yldzmuhammed/STF7-SoM/lcdboard/7 Inch Module/doc/TFT7.JPG

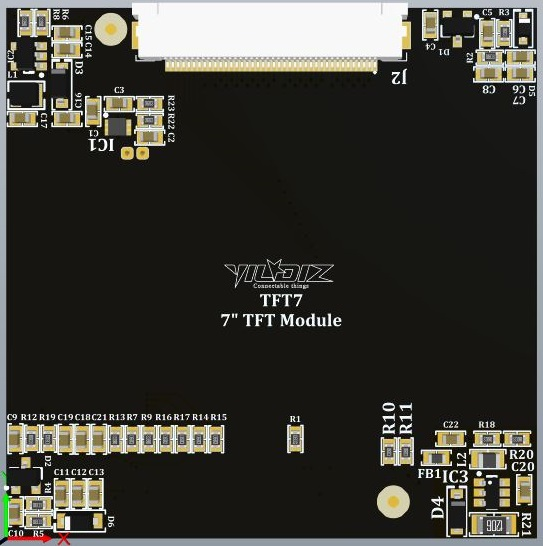
lcdboard/7 Inch Module/doc/TFT7.JPG
