yldzmuhammed/STF7-SoM/README.md

# STM32F7 Base Board

STM32F7 için hazırlanan temel kart.

Üzerinde bazı kritik çevre birimleri için bağlantı uçları yer alacak.

- SDRAM
- QSPI
- LCD with TouchPanel
- DCMI 
- UART with Rx, Tx, RTS, CTS, RING and control pins
- USB device with power
- Battery charger 1A
