yldzmuhammed/STF7-SoM/doc/Digikey Entegrelerde Çıkan Sorunlar.docx

# AP7362-33SP-13DICT-ND

Bu ürünle ilgili sorun, çıkış voltajının istenen seviyenin üzerinde olması. Bu ürün Datasheet’e göre çıkışında 3.3 volt sabit çıkış vermesi gereken bir ürün. Ancak girişinde 5 volt olduğunda, çıkışından 3,7 volt alıyoruz. Bu da devre üzerinde yer alan entegrelerimize zarar veriyor.

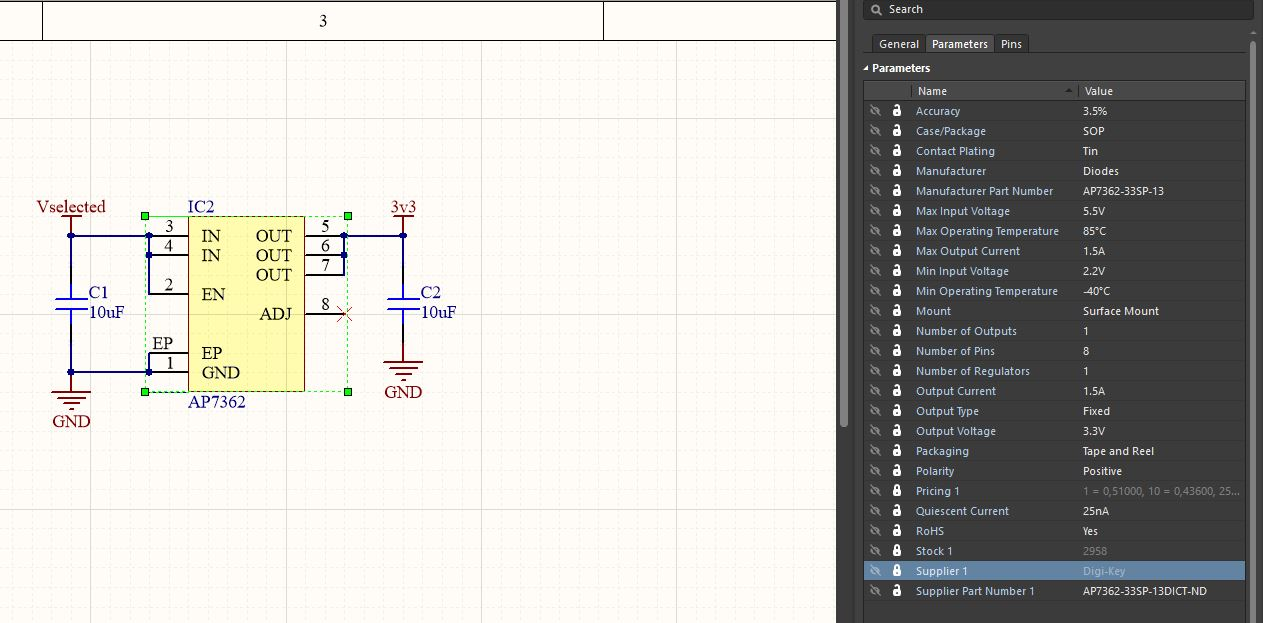
[picture p2: figure]
metin içeren bir resim Açıklama otomatik olarak oluşturuldu

# XC2884CT-ND

Bu üründen 2 adet satın alındı. Bu ürün çıkışında 24 MHz sinyal olması gerekirken, birinde hiç sinyal çıkışı alamadık, diğerinde 320 KHz sinyal çıkışı alabildik. Bu sebeple mikrodenetleyicimize çalışması için gereken saat kaynağını sağlayamadık.

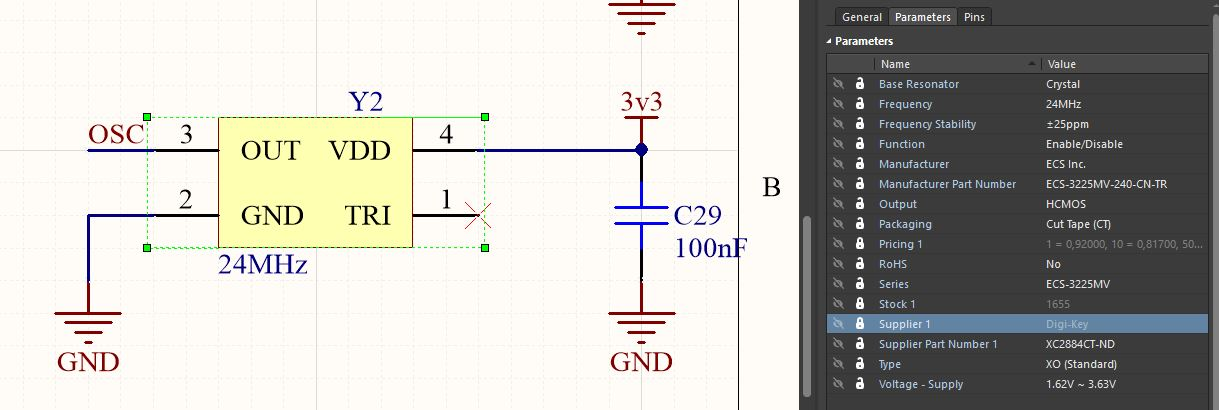
[picture p3: figure]
metin, saat içeren bir resim Açıklama otomatik olarak oluşturuldu

# 497-18106-ND

Bu ürün ST Microelectronics firmasının STM32F750N8 kodlu mikrodenetleyicisi.

- Normal şartlarda, sistemin çalışma frekansını görebilmek için PC9 ve PA8 pinlerinden saat çıkışı alabiliyor olmamız gerekirdi. Ancak bu sinyali göremiyoruz.
- Diğer başlıklarda da belirtilen hafıza entegreleriyle haberleşemiyoruz. Normal şartlarda SDRAM belleğe sorunsuz erişim sağlayabilmemiz, veri yazıp okuyabilmemiz gerekirdi. Ayrıca Paralel ve QUAD SPI NOR Flash entegrelerine de sorunsuz erişim sağlayabilmemiz, çip kimlik numaralarını okuyabilmemiz, veri yazıp okuyabilmemiz gerekirdi. Ancak bunu yapamıyoruz.
- Sorunsuz şekilde USB HS (High Speed) Device modundan PC ile iletişim kurabilmemiz, veri alışverişi yapabilmemiz gerekirdi. USB DFU, USB CDC, USB HID sınıflarından hiçbiriyle iletişim kuramıyoruz. Entegre içerisindeki USB donanımının zarar gördüğünü düşünüyoruz.
- SDIO birimini kullanarak SD Card (Hafıza kartı) ile iletişim kurabilmemiz ve karta veri yazıp okuyabilmemiz gerekirdi. Bunu yapamıyoruz.
- LTDC, DCMI gibi çevre birimlerini de kullanmamız gerekiyor. Ancak yukarıdaki sorunları çözemediğimiz için bu çevre birimlerini test edemiyoruz.
- 10KB dan daha büyük program yüklemeye kalktığımızda orijinal J-Link adaptörümüz, “Memory Miss Match” şeklinde hata veriyor. Sebebi program yükleme doğru veya hatalı şekilde gerçekleşiyor ancak yükleme sonrası çalışan doğrulama işlemi sırasında yazılmış olması gereken programın doğru şekilde yazılamadığı görülüyor. Yani program da yükleyemiyoruz.

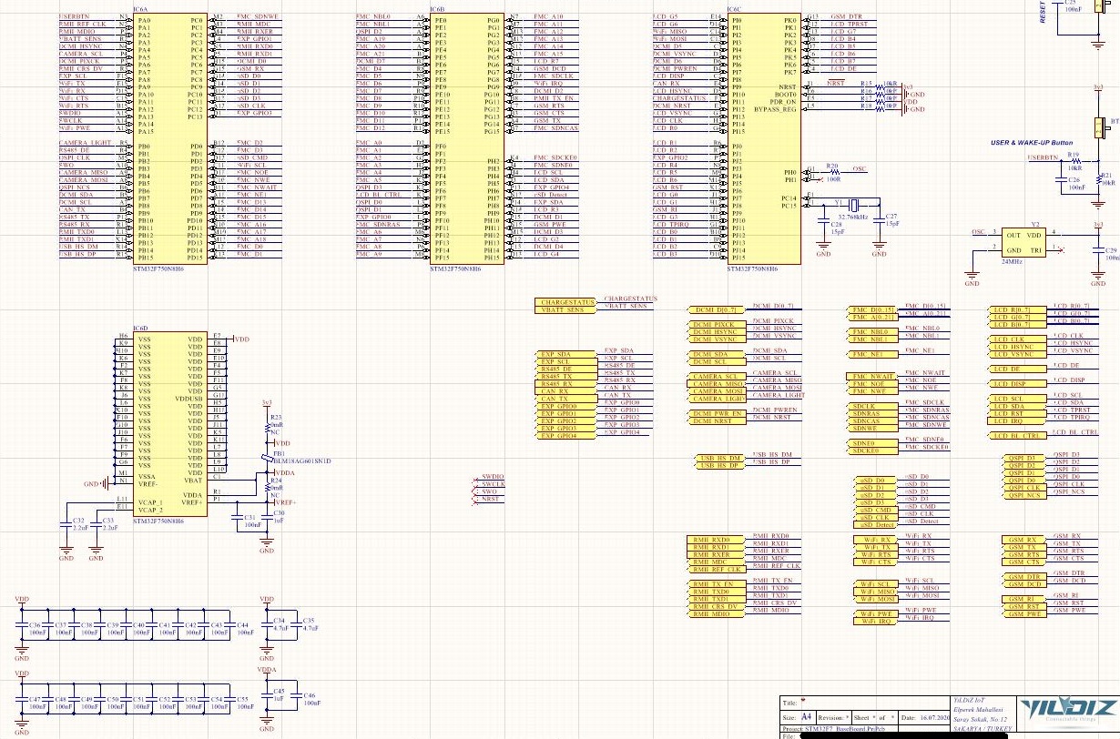
[picture p4: figure]
metin içeren bir resim Açıklama otomatik olarak oluşturuldu

# W25Q128JVPIM-ND

Bu ürün QUAD SPI NOR Flash. Normal şartlarda, mikrodenetleyici ile haberleşerek kimlik numarasını okuyabilmeli, veri yazıp okuyabilmeliydik. Ancak herhangi bir şekilde haberleşme sağlayamıyoruz. Ne kimlik numarasını okuyabiliyoruz ne de veri yazıp okuyabiliyoruz.

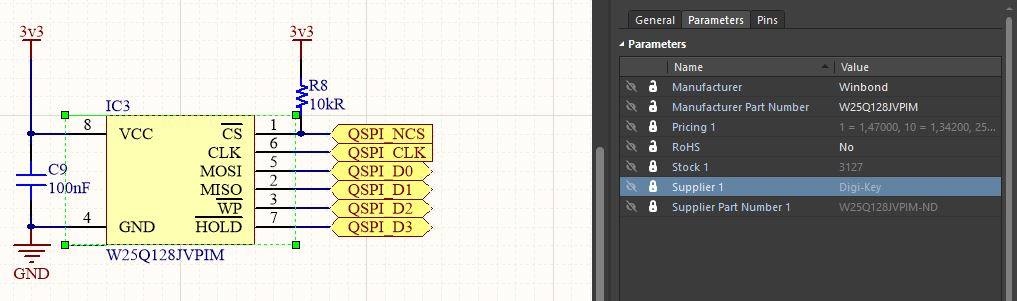
[picture p5: figure]

# 557-1777-ND

Bu ürün 22 Bit Paralel NOR Flash. Normal şartlarda, mikrodenetleyici ile haberleşerek kimlik numarasını okuyabilmeli, veri yazıp okuyabilmeliydik. Ancak herhangi bir şekilde haberleşme sağlayamıyoruz. Ne kimlik numarasını okuyabiliyoruz ne de veri yazıp okuyabiliyoruz.

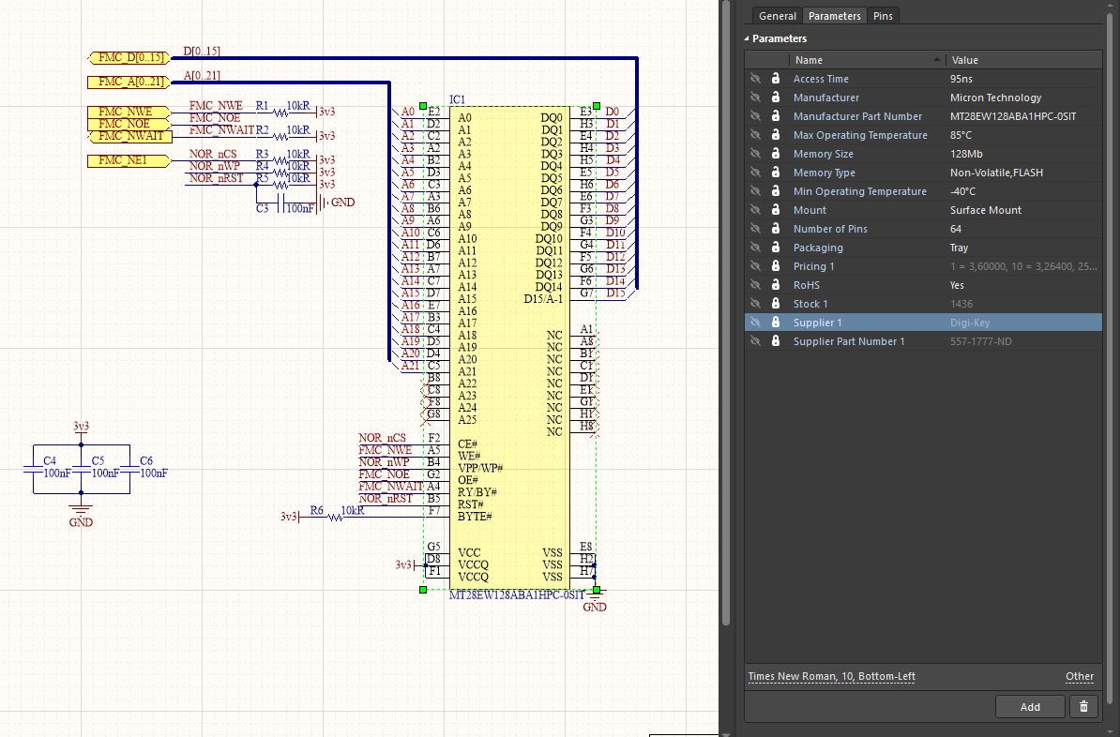
[picture p6: figure]

# 1450-1350-1-ND

Bu ürün 256 MegaBit SDRAM. Normal şartlarda, mikrodenetleyici ile haberleşerek veri yazıp okuyabilmeliydik. Ancak herhangi bir şekilde haberleşme sağlayamıyoruz. Ancak veri yazıp okuyabiliyoruz.

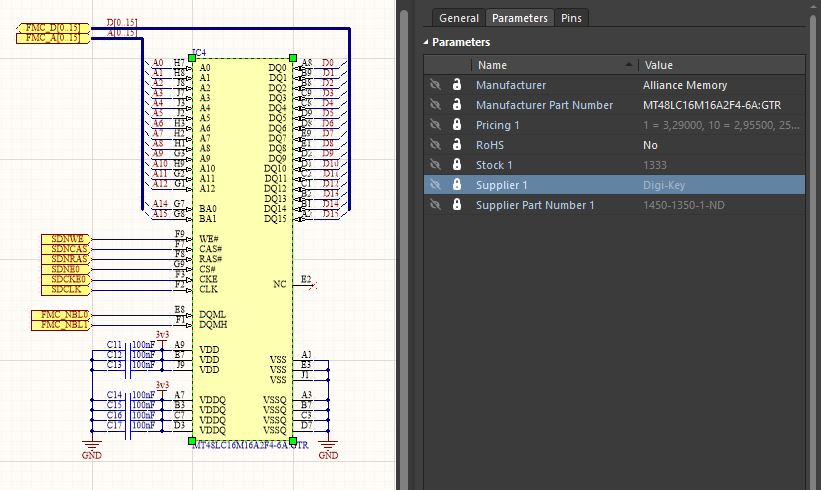
[picture p7: figure]
ekran görüntüsü içeren bir resim Açıklama otomatik olarak oluşturuldu
