yldzmuhammed/STF7-SoM/doc/System Blog Diagram.png

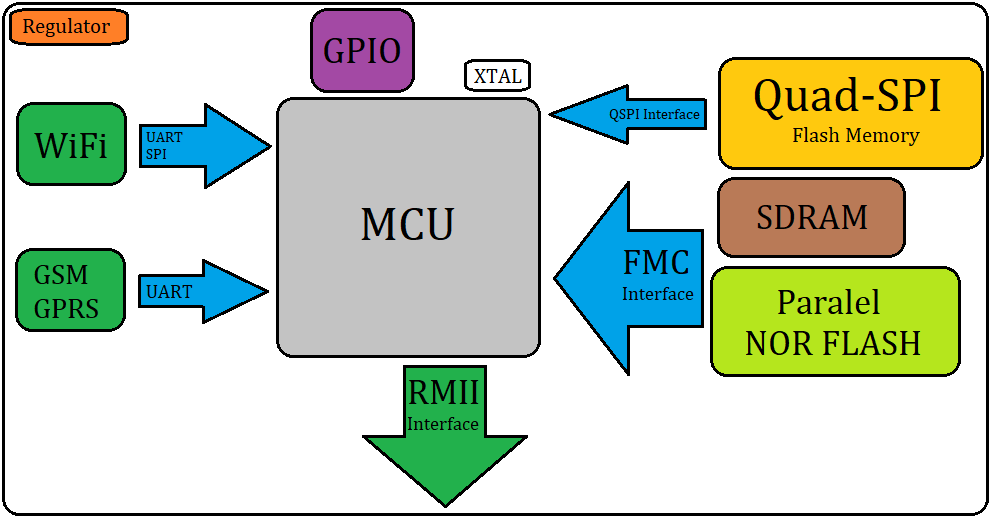
doc/System Blog Diagram.png
