yldzmuhammed/STF7-SoM/mechanical/ST7-SoM.PNG

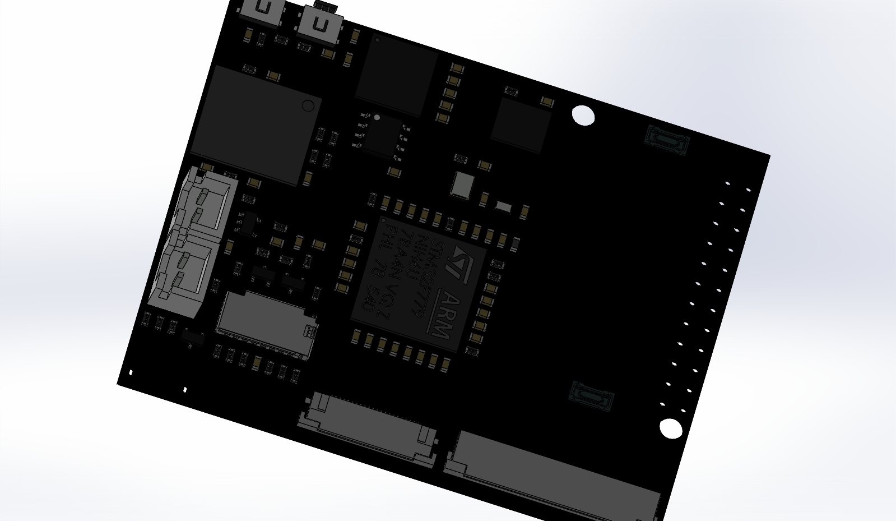
mechanical/ST7-SoM.PNG
