yldzmuhammed/STF7-SoM/lcdboard/7 Inch Module/doc/7IncModule BOM-7 Inch Module.xls

Sheet: BOM Report
Bill of Materials |  |  | 7IncModule BOM for Project [7 Inch Module.PrjPcb] (No PCB Document Selected)
Source Data From: |  | 7 Inch Module.PrjPcb
Project: |  | 7 Inch Module.PrjPcb
Variant: |  | None
Creation Date: | 19.05.2020 | 15:45
Print Date: | 2020-06-29 | 12:41:12
Production Quantity: | 1
Currency | USD
Comment | Designator | Footprint | Description | Supplier 1 | Supplier Part Number 1 | Manufacturer Part Number | Pricing 1 | Quantity | Price | Supplier Subtotal 1
1uF | C1, C2, C7, C12, C14, C17, C19 | CAP 0603/1608 | Ceramic, SMT Capacitor | Digi-Key | 1276-1182-1-ND | CL10A105KP8NNNC | 1 = 0,10000, 10 = 0,03800, 100 = 0,01680, 500 = 0,01200, 1000 = 0,00943 (USD) | 7 | 0.1 | $0.70
100nF | C3, C4, C5, C8, C9, C10, C13, C21 | CAP 0603/1608 | Capacitor, Ceramic, Ceramic, SMT Capacitor | Digi-Key | 1276-1857-1-ND | CL10A104KA8NNNC | 1 = 0,10000, 10 = 0,04600, 100 = 0,02070, 500 = 0,01478, 1000 = 0,01162 (USD), 1 = 0,10000, 10 = 0,04500, 100 = 0,02000, 500 = 0,01428, 1000 = 0,01122 (USD) | 8 | 0.1 | $0.80
10uF | C6, C11, C15, C16, C18, C20 | CAP 0603/1608 | Ceramic, SMT Capacitor | Digi-Key | 1276-1119-1-ND | CL10A106MQ8NNNC | 1 = 0,15000, 10 = 0,11000, 100 = 0,05150, 500 = 0,03614, 1000 = 0,02992 (USD) | 6 | 0.15 | $0.90
1uF | C22 | CAP 0603/1608 | Ceramic, SMT Capacitor | Digi-Key | 1276-1034-1-ND | CL10A105KO8NNNC | 1 = 0,10000, 10 = 0,03800, 100 = 0,01680, 500 = 0,01198, 1000 = 0,00941 (USD) | 1 | 0.1 | $0.10
BAT54S,235 | D1, D2 | DIODES SOT-23-3 | TVS Array | Digi-Key | 1727-1868-1-ND | BAT54S,235 | 1 = 0,14000, 10 = 0,12500, 25 = 0,11880, 100 = 0,05230, 250 = 0,05016, 500 = 0,04104, 1000 = 0,02850, 2500 = 0,02489, 5000 = 0,02233 (USD) | 2 | 0.14 | $0.28
1N5819HW-7-F | D3 | SOD-123 | Zener Diode | Digi-Key | 1N5819HW-FDICT-ND | 1N5819HW-7-F | 1 = 0,40000, 10 = 0,30100, 25 = 0,26360, 100 = 0,14310, 250 = 0,14240, 500 = 0,11678, 1000 = 0,08664 (USD) | 1 | 0.4 | $0.40
BAT54GWJ | D4 | SOD-123 | Zener Diode | Digi-Key | 1727-7328-1-ND | BAT54GWJ | 1 = 0,14000, 10 = 0,13100, 100 = 0,07140, 500 = 0,04396, 1000 = 0,02997 (USD) | 1 | 0.14 | $0.14
DDZ7V5ASF-7 | D5 | SOD323F | Zener Diode | Digi-Key | DDZ7V5ASF-7DICT-ND | DDZ7V5ASF-7 | 1 = 0,15000, 10 = 0,14100, 25 = 0,13400, 100 = 0,05890, 250 = 0,05656, 500 = 0,04626, 1000 = 0,03213 (USD) | 1 | 0.15 | $0.15
PDZ16BGWJ | D6 | SOD123F | Zener Diode | Digi-Key | 1727-7765-1-ND | PDZ16BGWJ | 1 = 0,17000, 10 = 0,15400, 25 = 0,14640, 100 = 0,06440, 250 = 0,06176, 500 = 0,05054, 1000 = 0,03510, 2500 = 0,03066, 5000 = 0,02750 (USD) | 1 | 0.17 | $0.17
BLM18PG-121SN1D | FB1 | FER 0603/1608 | SMT Ferrite Chip | Digi-Key | 490-1037-1-ND | BLM18PG-121SN1D | 1 = 0,10000, 10 = 0,07600, 25 = 0,06840, 50 = 0,05000, 100 = 0,04330, 250 = 0,03416, 500 = 0,02884, 1000 = 0,02429 (USD) | 1 | 0.1 | $0.10
MIC5353YMT-TR | IC1 | MICREL MLF-6 1.6x1.6MM | Integrated Circuit | Digi-Key | 576-3681-1-ND | MIC5353YMT-TR | 1 = 0,34000, 25 = 0,28000, 100 = 0,26000 (USD) | 1 | 0.34 | $0.34
AP3012KTR-G1 | IC2 | DIODES SOT-23-5 W5 | 1.5MHz STEP-UP DC-DC CONVERTER | Digi-Key | AP3012KTR-G1DICT-ND | AP3012KTR-G1 | 1 = 0,47000, 10 = 0,38000, 25 = 0,34760, 100 = 0,23430, 250 = 0,19392, 500 = 0,17776, 1000 = 0,13332 (USD) | 1 | 0.47 | $0.47
AP3032KTR-G1 | IC3 | DIODES SOT-23-6 W6 |  | Digi-Key | AP3032KTR-G1DICT-ND | AP3032KTR-G1 | 1 = 0,48000, 10 = 0,36500, 100 = 0,22740, 500 = 0,15558, 1000 = 0,11968 (USD) | 1 | 0.48 | $0.48
62684-501100ALF | J1 | Amphenol 62684-501100ALF | Connector | Digi-Key | 609-1197-1-ND | 62684-501100ALF | 1 = 0,96000, 10 = 0,84700, 25 = 0,79680, 50 = 0,76360, 100 = 0,73040, 250 = 0,66396, 500 = 0,59756, 1000 = 0,53117 (USD) | 1 | 0.96 | $0.96
62684-401100ALF | J2 | Amphenol 62684-401100ALF | Connector | Digi-Key | 609-1195-1-ND | 62684-401100ALF | 1 = 0,97000, 10 = 0,85600, 25 = 0,80600, 50 = 0,77240, 100 = 0,73880, 250 = 0,67168, 500 = 0,60450, 1000 = 0,53733 (USD) | 1 | 0.97 | $0.97
1734592-6 | J6 | FPC-6 |  | Digikey | A144895CT-ND | 1734592-6 | 1 = 0,44000, 10 = 0,41400, 25 = 0,37280, 50 = 0,33140, 100 = 0,31760, 250 = 0,28996, 500 = 0,27616, 1000 = 0,22783 (USD) | 1 | 0.44 | $0.44
10uH | L1 | TAIYO YUDEN MAMK2520T1R0M |  | Digi-Key | 2037-SDET25201T-100MSCT-ND | SDET25201T-100MS | 1 = 0,26000, 10 = 0,23300, 100 = 0,16050, 500 = 0,13714 1000 = 0,10505 (USD) | 1 | 0.26 | $0.26
6.8uH | L2 | FER 0805/2012 |  | Digi-Key | 445-6402-1-ND | MLZ2012M6R8WT000 | 1 = 0,14000, 10 = 0,12900, 100 = 0,08630, 500 = 0,07188, 1000 = 0,06038 (USD) | 1 | 0.14 | $0.14
1kR | R1, R8, R9, R10, R11, R13, R19 | RES 0603/1608 | Ceramic, SMT Capacitor | Digi-Key | 311-1.00KHRCT-ND | RC0603FR-071KL | 1 = 0,10000, 10 = 0,02300, 100 = 0,00940, 1000 = 0,00421, 2500 = 0,00366 (USD) | 7 | 0.1 | $0.70
15kR | R6 | RES 0603/1608 | Ceramic, SMT Capacitor | Digi-Key | 311-15.0KHRCT-ND | RC0603FR-0715KL | 1 = 0,10000, 10 = 0,02300, 100 = 0,00940, 1000 = 0,00421, 2500 = 0,00366 (USD) | 1 | 0.1 | $0.10
47kR | R18 | RES 0603/1608 | Ceramic, SMT Capacitor | Digi-Key | 311-47.0KHRCT-ND | RC0603FR-0747KL | 1 = 0,10000, 10 = 0,02400, 100 = 0,00970, 1000 = 0,00437, 2500 = 0,00379 (USD) | 1 | 0.1 | $0.10
68kR | R20 | RES 0603/1608 | Ceramic, SMT Capacitor | Digi-Key | 311-68.0KHRCT-ND | RC0603FR-0768KL | 1 = 0,10000, 10 = 0,02400, 100 = 0,00970, 1000 = 0,00437, 2500 = 0,00379 (USD) | 1 | 0.1 | $0.10
5.6R | R21 | RES 1206/3216 | Ceramic, SMT Capacitor | Digi-Key | RHM5.6ICT-ND | ESR18EZPJ5R6 | 1 = 0,16000, 10 = 0,13300, 100 = 0,05200, 1000 = 0,02178, 2500 = 0,01996 (USD) | 1 | 0.16 | $0.16
14kR | R22 | RES 0603/1608 | Ceramic, SMT Capacitor | Digi-Key | 311-14.0KHRCT-ND | RC0603FR-0714KL | 1 = 0,10000, 10 = 0,02300, 100 = 0,00940, 1000 = 0,00421, 2500 = 0,00366 (USD) | 1 | 0.1 | $0.10
10kR | R23 | RES 0603/1608 | Ceramic, SMT Capacitor | Digi-Key | RNCP0603FTD10K0CT-ND | RNCP0603FTD10K0 | 1 = 0,10000, 10 = 0,06700, 100 = 0,02730, 1000 = 0,01224, 2500 = 0,01063 (USD) | 1 | 0.1 | $0.10
 |  |  |  |  |  |  |  | 50 |  | $9.16
Approved |  | Notes

Sheet: Project Information
Project Full Path | P:\YILDIZIoT\TFT-LCD Modules\7 Inch Module\hw\7 Inch Module.PrjPcb
Project Filename | 7 Inch Module.PrjPcb
Variant Name | None
Data-Source Filename | 7 Inch Module.PrjPcb
Data-Source Full Path | P:\YILDIZIoT\TFT-LCD Modules\7 Inch Module\hw\7 Inch Module.PrjPcb
Title | 7IncModule BOM for Project [7 Inch Module.PrjPcb] (No PCB Document Selected)
Total Quantity | 50
Report Time | 15:45
Report Date | 19.05.2020
Report Date & Tine | 19.05.2020 15:45
Output Name | 7IncModule BOM
Output Type | BOM_PartType
Output Generator Name | BOM
Output Generator Description | Bill of Materials
