yldzmuhammed/STF7-SoM/baseboard/Project Outputs for STM32F7_BaseBoard/BOM/Base Board BOM-STM32F7_BaseBoard.xls

Sheet: BOM Report
Bill of Materials |  |  | Base Board BOM for Project [STM32F7_BaseBoard.PrjPcb] (No PCB Document Selected)
Source Data From: |  | STM32F7_BaseBoard.PrjPcb
Project: |  | STM32F7_BaseBoard.PrjPcb
Variant: |  | None
Creation Date: | 19.05.2020 | 15:52
Print Date: | 2020-05-19 | 15:54:15
Production Quantity: | 1
Currency | USD
Comment | Designator | Footprint | Description | Supplier 1 | Supplier Part Number 1 | Manufacturer Part Number | Pricing 1 | Quantity | #Column Name Error:' Price | Supplier Subtotal 1
USB Micro | µUSB1 | FCI USB 10118193-0001LF |  | Digi-Key | 609-4616-1-ND | 10118193-0001LF | 1 = 0,43000, 10 = 0,40500, 25 = 0,36480, 50 = 0,32420, 100 = 0,31070, 250 = 0,28368, 500 = 0,27016 (USD) | 1 | 0.43 | $0.43
#NAME? | BT1, BT2 | TactileButton | Button, 2 pin | Digi-Key | P16767CT-ND | EVQP7J01P | 1 = 0,30000, 10 = 0,28600, 25 = 0,27600, 50 = 0,26560, 100 = 0,25550, 250 = 0,23504, 500 = 0,20438, 1000 = 0,17372 (USD) | 2 | 0.3 | $0.60
10uF | C1, C2, C61, C62 | CAP 0603/1608 | Ceramic, SMT Capacitor | Digi-Key | 1276-1119-1-ND | CL10A106MQ8NNNC | 1 = 0,15000, 10 = 0,11000, 100 = 0,05150, 500 = 0,03614, 1000 = 0,02992 (USD) | 4 | 0.15 | $0.60
100nF | C3, C4, C5, C6, C9, C10, C11, C12, C13, C14, C15, C16, C17, C26, C29, C31, C36, C37, C38, C39, C40, C41, C42, C43, C44, C46, C47, C48, C49, C50, C51, C52, C53, C54, C55 | CAP 0603/1608 | Ceramic, SMT Capacitor | Digi-Key | 1276-1033-1-ND | CL10B104JB8NNNC | 1 = 0,10000, 10 = 0,04800, 100 = 0,02160, 500 = 0,01540, 1000 = 0,01210 (USD), 1 = 0,10000, 10 = 0,05300, 100 = 0,02350, 500 = 0,01680, 1000 = 0,01320 (USD) | 35 | 0.048 | $1.68
15pF | C27, C28 | CAP 0603/1608 | Ceramic, SMT Capacitor | Digi-Key | 1292-1487-1-ND | 0603N150J500CT | 1 = 0,10000, 10 = 0,03300, 100 = 0,01490, 500 = 0,01062, 1000 = 0,00835 (USD) | 2 | 0.1 | $0.20
1uF | C30, C45 | CAP 0603/1608 | Ceramic, SMT Capacitor | Digi-Key | 1276-1182-1-ND | CL10A105KP8NNNC | 1 = 0,10000, 10 = 0,03800, 100 = 0,01680, 500 = 0,01200, 1000 = 0,00943 (USD) | 2 | 0.1 | $0.20
2.2uF | C32, C33 | CAP 0603/1608 | Ceramic, SMT Capacitor | Digi-Key | 1276-1183-1-ND | CL10A225KQ8NNNC | 1 = 0,11000, 10 = 0,07700, 100 = 0,03430, 500 = 0,02450, 1000 = 0,01925 (USD) | 2 | 0.11 | $0.22
4.7uF | C34, C35, C58 | CAP 0603/1608 | Ceramic, SMT Capacitor | Digi-Key | 1276-1907-1-ND | CL10A475MQ8NNNC | 1 = 0,10000, 10 = 0,06300, 100 = 0,02790, 500 = 0,01990, 1000 = 0,01564 (USD) | 3 | 0.1 | $0.30
10nF | C56 | CAP 0603/1608 | Ceramic, SMT Capacitor | Digi-Key | 399-1092-1-ND | C0603C103J5RACTU | 1 = 0,10000, 10 = 0,05300, 100 = 0,02360, 500 = 0,01682, 1000 = 0,01322 (USD) | 1 | 0.1 | $0.10
#NAME? | FB1 | FER 0603/1608 | SMT Ferrite Chip | Digi-Key | 490-1014-1-ND | BLM18AG601SN1D | 1 = 0,10000, 10 = 0,07900, 25 = 0,07200, 50 = 0,06480, 100 = 0,04760, 250 = 0,03460, 500 = 0,03170, 1000 = 0,02738 (USD) | 1 | 0.1 | $0.10
#NAME? | IC1 | MICRON LBGA-64 11X13mm | Parallel NOR Flash Embedded Memory | Digi-Key | 557-1777-ND | MT28EW128ABA1HPC-0SIT | 1 = 3,60000, 10 = 3,26400, 25 = 3,19320, 50 = 3,17540, 100 = 2,84780, 250 = 2,83716, 500 = 2,73266, 1000 = 2,59806 (USD) | 1 | 3.6 | $3.60
AP7362 | IC2 | DIODES SO-8-EP | The AP7362 is a 1.5A adjustable output voltage linear regulator with ultra-low dropout. | Digi-Key | AP7362-33SP-13DICT-ND | AP7362-33SP-13 | 1 = 0,51000, 10 = 0,43600, 25 = 0,40640, 100 = 0,30200, 250 = 0,25552, 500 = 0,24392, 1000 = 0,18003 (USD) | 1 | 0.51 | $0.51
#NAME? | IC3 | WINBOND WSON-8 6x5mm |  | Digi-Key | W25Q128JVPIM-ND | W25Q128JVPIM | 1 = 1,47000, 10 = 1,34200, 25 = 1,30640, 50 = 1,29940, 100 = 1,16150, 250 = 1,15808, 500 = 1,14084, 1000 = 1,09189, 5000 = 1,01675 (USD) | 1 | 1.47 | $1.47
#NAME? | IC4 | MICRON VFBGA-54 8X14MM | MT48LC64M4A2 – 16 Meg x 4 x 4 banks MT48LC32M8A2 – 8 Meg x 8 x 4 banks MT48LC16M16A2 – 4 Meg x 16 x 4 banks | Digi-Key | 1450-1350-1-ND | MT48LC16M16A2F4-6A:GTR | 1 = 3,29000, 10 = 2,95500, 25 = 2,90800, 50 = 2,90020, 100 = 2,59150, 250 = 2,50728, 500 = 2,49792, 1000 = 2,32640 (USD) | 1 | 3.29 | $3.29
#NAME? | IC6 | ST TFBGA-216 13x13 0.8mm | Arm®-based Cortex®-M7 32b MCU+FPU, 462DMIPS, 64KB Flash/320+16+ 4KB RAM, USB OTG HS/FS, 25 com IF, Cam, LCD | Digi-Key | 497-18106-ND | STM32F750N8H6 | 1 = 9,70000, 10 = 8,76200, 25 = 8,35480, 100 = 7,25440, 250 = 6,92836, 500 = 6,31702, 1000 = 5,50193 (USD) | 1 | 9.7 | $9.70
#NAME? | IC7 | INFINEON SOT-23-3 | MOSFET N-CH 20V 6.3A SOT-23 | Digi-Key | IRLML6244TRPBFCT-ND | IRLML6244TRPBF | 1 = 0,36000, 10 = 0,29400, 25 = 0,26880, 100 = 0,16880, 250 = 0,16688, 500 = 0,15626, 1000 = 0,10625 (USD) | 1 | 0.36 | $0.36
#NAME? | IC9 | INFINEON SOT-23-3 | MOSFET P-CH 20V 3.7A SOT-23 | Digi-Key | IRLML6402PBFCT-ND | IRLML6402TRPBF | 1 = 0,36000, 10 = 0,28800, 25 = 0,26360, 100 = 0,16550, 250 = 0,16368, 500 = 0,15326, 1000 = 0,10421 (USD) | 1 | 0.36 | $0.36
#NAME? | IC10 | MICROCHIP SOT-23-5 OT | Miniature Single-Cell, Fully integrated Li-Ion, Li-Polymer charge management controllers | Digi-Key | MCP73831T-2ACI/OTCT-ND | MCP73831T-2ACI/OT | 1 = 0,56000, 25 = 0,47000, 100 = 0,42000 (USD) | 1 | 0.56 | $0.56
#NAME? | J1 | fpc-22 | Connector | Digi-Key | 609-4319-1-ND | SFV22R-2STE1HLF | 1 = 0,79000, 10 = 0,74300, 25 = 0,66840, 50 = 0,59420, 100 = 0,56950, 250 = 0,52000, 500 = 0,49522, 1000 = 0,40856 (USD) | 1 | 0.79 | $0.79
#NAME? | J2 | fpc-40 | Connector | Digi-Key | 609-1195-1-ND | 62684-401100ALF | 1 = 0,97000, 10 = 0,85600, 25 = 0,80600, 50 = 0,77240, 100 = 0,73880, 250 = 0,67168, 500 = 0,60450, 1000 = 0,53733 (USD) | 1 | 0.97 | $0.97
#NAME? | J3 | Molex - 0475710001 | Connector | Digi-Key | WM9731CT-ND | 0475710001 | 1 = 1,030000, 10 = 0,906000, 25 = 0,852400, 50 = 0,817000, 100 = 0,781400, 250 = 0,710400, 500 = 0,639340 (USD) | 1 | 1.03 | $1.03
#NAME? | J5, J6, J7, J8, J11 | HIROSE BM2410DS | Board to Board Connector | Digi-Key | H124928CT-ND | BM24-10DS/2-0.35V(53) | 1 = 1,05000, 10 = 0,92600, 25 = 0,87120, 50 = 0,83500, 100 = 0,79860, 250 = 0,72600, 500 = 0,65340 (USD) | 5 | 1.05 | $5.25
10kR | R1, R2, R3, R4, R5, R6, R8, R14, R15, R16, R17, R18, R19, R21, R22, R30, R31, R32, R33, R35 | RES 0603/1608 | Ceramic, SMT Capacitor | Digi-Key | RNCP0603FTD10K0CT-ND | RNCP0603FTD10K0 | 1 = 0,10000, 10 = 0,06700, 100 = 0,02730, 1000 = 0,01224, 2500 = 0,01063 (USD) | 20 | 0.067 | $1.34
4.7kR | R9, R10, R11, R12, R13 | RES 0603/1608 | Ceramic, SMT Capacitor | Digi-Key | 311-4.7KGRCT-ND | RC0603JR-074K7L | 1 = 0,10000, 10 = 0,02000, 100 = 0,00810, 1000 = 0,00362, 2500 = 0,00314 (USD) | 5 | 0.1 | $0.50
20R | R25, R26 | RES 0603/1608 | Ceramic, SMT Capacitor | Digi-Key | P20.0HCT-ND | ERJ3EKF20R0V | 1 = 0,10000, 10 = 0,06500, 100 = 0,02640, 1000 = 0,01186, 2500 = 0,01029 (USD) | 2 | 0.1 | $0.20
4.7kR | R27 | RES 0603/1608 | Ceramic, SMT Capacitor | Digi-Key | 311-4.70KHRCT-ND | RC0603FR-074K7L | 1 = 0,10000, 10 = 0,02400, 100 = 0,00970, 1000 = 0,00437, 2500 = 0,00379 (USD) | 1 | 0.1 | $0.10
30MR | R28, R29 | RES 0603/1608 | Ceramic, SMT Capacitor | Digi-Key | 541-30MAHCT-ND | CRCW060330M0JPEAHR | 1 = 0,40000, 10 = 0,28500, 100 = 0,11390, 1000 = 0,05610, 2500 = 0,05198 (USD) | 2 | 0.4 | $0.80
1kR | R34 | RES 0603/1608 | Ceramic, SMT Capacitor | Digi-Key | RHM1.0KDCT-ND | ESR03EZPJ102 | 1 = 0,10000, 10 = 0,08300, 100 = 0,03180, 1000 = 0,01398, 2500 = 0,01207 (USD) | 1 | 0.1 | $0.10
32.768kHz | Y1 | ABRACON ABS06 | CRYSTAL 32.7680KHZ 12.5PF SMD | Digi-Key | 535-10248-1-ND | ABS06-32.768KHZ-1-T | 1 = 0,80000, 10 = 0,70800, 50 = 0,66220, 100 = 0,58520, 500 = 0,55440, 1000 = 0,46200 (USD) | 1 | 0.8 | $0.80
24MHz | Y2 | Abracon ASTX-11 | OSC XO 1.544MHZ CMOS SMD | Digi-Key | XC2884CT-ND | ECS-3225MV-240-CN-TR | 1 = 0,92000, 10 = 0,81700, 50 = 0,76380, 100 = 0,67510, 500 = 0,63954 (USD) | 1 | 0.92 | $0.92
 |  |  |  |  |  |  |  | 102 |  | $37.08
Approved |  | Notes

Sheet: Project Information
Project Full Path | P:\YILDIZIoT\STM32F7-Base-Board\STM32F7_BaseBoard\STM32F7_BaseBoard.PrjPcb
Project Filename | STM32F7_BaseBoard.PrjPcb
Variant Name | None
Data-Source Filename | STM32F7_BaseBoard.PrjPcb
Data-Source Full Path | P:\YILDIZIoT\STM32F7-Base-Board\STM32F7_BaseBoard\STM32F7_BaseBoard.PrjPcb
Title | Base Board BOM for Project [STM32F7_BaseBoard.PrjPcb] (No PCB Document Selected)
Total Quantity | 102
Report Time | 15:52
Report Date | 19.05.2020
Report Date & Tine | 19.05.2020 15:52
Output Name | Base Board BOM
Output Type | BOM_PartType
Output Generator Name | BOM
Output Generator Description | Bill of Materials
