yldzmuhammed/STF7-SoM/baseboard/Project Outputs for STM32F7_BaseBoard/BOM/Camera BOM-Camera.xls

Sheet: BOM Report
Bill of Materials |  |  | Camera BOM for Schematic Document [Camera.SchDoc]
Source Data From: |  | Camera.SchDoc
Project: |  | STM32F7_BaseBoard.PrjPcb
Variant: |  | None
Creation Date: | 10.04.2020 | 14:39
Print Date: | 2020-04-10 | 14:43:00
Production Quantity: | 1
Currency | USD
Comment | Designator | Footprint | Description | Supplier 1 | Supplier Part Number 1 | Manufacturer Part Number | Pricing 1 | Quantity | #Column Name Error:' Price | Supplier Subtotal 1
SFV22R-2STE1HLF | J1 | fpc-22 | Connector | Digi-Key | 609-4319-1-ND | SFV22R-2STE1HLF | 1 = 0,79000, 10 = 0,74300, 25 = 0,66840, 50 = 0,59420, 100 = 0,56950, 250 = 0,52000, 500 = 0,49522, 1000 = 0,40856 (USD) | 1 | 0.79 | $0.79
 |  |  |  |  |  |  |  |  |  | $0.00
 |  |  |  |  |  |  |  |  |  | $0.00
 |  |  |  |  |  |  |  | 1 |  | $0.79
Approved |  | Notes

Sheet: Project Information
Project Full Path | P:\YILDIZIoT\STM32F7-Base-Board\STM32F7_BaseBoard\STM32F7_BaseBoard.PrjPcb
Project Filename | STM32F7_BaseBoard.PrjPcb
Variant Name | None
Data-Source Filename | Camera.SchDoc
Data-Source Full Path | P:\YILDIZIoT\STM32F7-Base-Board\STM32F7_BaseBoard\Camera.SchDoc
Title | Camera BOM for Schematic Document [Camera.SchDoc]
Total Quantity | 1
Report Time | 14:39
Report Date | 10.04.2020
Report Date & Tine | 10.04.2020 14:39
Output Name | Camera BOM
Output Type | BOM_PartType
Output Generator Name | BOM
Output Generator Description | Bill of Materials
