yldzmuhammed/STF7-SoM/baseboard/Project Outputs for STM32F7_BaseBoard/BOM/Connection BOM-Connections.xls

Sheet: BOM Report
Bill of Materials |  |  | Connection BOM for Schematic Document [Connections.SchDoc]
Source Data From: |  | Connections.SchDoc
Project: |  | STM32F7_BaseBoard.PrjPcb
Variant: |  | None
Creation Date: | 10.04.2020 | 14:40
Print Date: | 2020-04-10 | 14:42:15
Production Quantity: | 1
Currency | USD
Comment | Designator | Footprint | Description | Supplier 1 | Supplier Part Number 1 | Manufacturer Part Number | Pricing 1 | Quantity | #Column Name Error:' Price | Supplier Subtotal 1
BM24-10DS/2-0.35V(53) | J5, J6, J7, J8, J11, J12, J13 | HIROSE BM2410DS | Board to Board Connector | Digi-Key | H124928CT-ND | BM24-10DS/2-0.35V(53) | 1 = 1,05000, 10 = 0,92600, 25 = 0,87120, 50 = 0,83500, 100 = 0,79860, 250 = 0,72600, 500 = 0,65340 (USD) | 7 | 1.05 | $7.35
 |  |  |  |  |  |  |  |  |  | $0.00
 |  |  |  |  |  |  |  |  |  | $0.00
 |  |  |  |  |  |  |  | 7 |  | $7.35
Approved |  | Notes

Sheet: Project Information
Project Full Path | P:\YILDIZIoT\STM32F7-Base-Board\STM32F7_BaseBoard\STM32F7_BaseBoard.PrjPcb
Project Filename | STM32F7_BaseBoard.PrjPcb
Variant Name | None
Data-Source Filename | Connections.SchDoc
Data-Source Full Path | P:\YILDIZIoT\STM32F7-Base-Board\STM32F7_BaseBoard\Connections.SchDoc
Title | Connection BOM for Schematic Document [Connections.SchDoc]
Total Quantity | 7
Report Time | 14:40
Report Date | 10.04.2020
Report Date & Tine | 10.04.2020 14:40
Output Name | Connection BOM
Output Type | BOM_PartType
Output Generator Name | BOM
Output Generator Description | Bill of Materials
