yldzmuhammed/STF7-SoM/baseboard/Project Outputs for STM32F7_BaseBoard/BOM/LCD BOM-LCD.xls

Sheet: BOM Report
Bill of Materials |  |  | LCD BOM for Schematic Document [LCD.SchDoc]
Source Data From: |  | LCD.SchDoc
Project: |  | STM32F7_BaseBoard.PrjPcb
Variant: |  | None
Creation Date: | 10.04.2020 | 14:39
Print Date: | 2020-04-10 | 14:43:03
Production Quantity: | 1
Currency | USD
Comment | Designator | Footprint | Description | Supplier 1 | Supplier Part Number 1 | Manufacturer Part Number | Pricing 1 | Quantity | #Column Name Error:' Price | Supplier Subtotal 1
62684-401100ALF | J2 | fpc-40 | Connector | Digi-Key | 609-1195-1-ND | 62684-401100ALF | 1 = 0,97000, 10 = 0,85600, 25 = 0,80600, 50 = 0,77240, 100 = 0,73880, 250 = 0,67168, 500 = 0,60450, 1000 = 0,53733 (USD) | 1 | 0.97 | $0.97
 |  |  |  |  |  |  |  |  |  | $0.00
 |  |  |  |  |  |  |  |  |  | $0.00
 |  |  |  |  |  |  |  | 1 |  | $0.97
Approved |  | Notes

Sheet: Project Information
Project Full Path | P:\YILDIZIoT\STM32F7-Base-Board\STM32F7_BaseBoard\STM32F7_BaseBoard.PrjPcb
Project Filename | STM32F7_BaseBoard.PrjPcb
Variant Name | None
Data-Source Filename | LCD.SchDoc
Data-Source Full Path | P:\YILDIZIoT\STM32F7-Base-Board\STM32F7_BaseBoard\LCD.SchDoc
Title | LCD BOM for Schematic Document [LCD.SchDoc]
Total Quantity | 1
Report Time | 14:39
Report Date | 10.04.2020
Report Date & Tine | 10.04.2020 14:39
Output Name | LCD BOM
Output Type | BOM_PartType
Output Generator Name | BOM
Output Generator Description | Bill of Materials
