yldzmuhammed/STF7-SoM/baseboard/Project Outputs for STM32F7_BaseBoard/BOM/NOR BOM-Paralel NOR FLASH.xls

Sheet: BOM Report
Bill of Materials |  |  | NOR BOM for Schematic Document [Paralel NOR FLASH.SchDoc]
Source Data From: |  | Paralel NOR FLASH.SchDoc
Project: |  | STM32F7_BaseBoard.PrjPcb
Variant: |  | None
Creation Date: | 10.04.2020 | 14:38
Print Date: | 2020-04-10 | 14:43:12
Production Quantity: | 1
Currency | USD
Comment | Designator | Footprint | Description | Supplier 1 | Supplier Part Number 1 | Manufacturer Part Number | Pricing 1 | Quantity | #Column Name Error:' Price | Supplier Subtotal 1
100nF | C3, C4, C5, C6 | CAP 0603/1608 | Ceramic, SMT Capacitor | Digi-Key | 1276-1033-1-ND | CL10B104JB8NNNC | 1 = 0,10000, 10 = 0,04800, 100 = 0,02160, 500 = 0,01540, 1000 = 0,01210 (USD) | 4 | 0.1 | $0.40
MT28EW128ABA1HPC-0SIT | IC1 | MICRON LBGA-64 11X13mm | Parallel NOR Flash Embedded Memory | Digi-Key | 557-1777-ND | MT28EW128ABA1HPC-0SIT | 1 = 3,60000, 10 = 3,26400, 25 = 3,19320, 50 = 3,17540, 100 = 2,84780, 250 = 2,83716, 500 = 2,73266, 1000 = 2,59806 (USD) | 1 | 3.6 | $3.60
10kR | R1, R2, R3, R4, R5, R6 | RES 0603/1608 | Ceramic, SMT Capacitor | Digi-Key | RNCP0603FTD10K0CT-ND | RNCP0603FTD10K0 | 1 = 0,10000, 10 = 0,06700, 100 = 0,02730, 1000 = 0,01224, 2500 = 0,01063 (USD) | 6 | 0.1 | $0.60
 |  |  |  |  |  |  |  | 11 |  | $4.60
Approved |  | Notes

Sheet: Project Information
Project Full Path | P:\YILDIZIoT\STM32F7-Base-Board\STM32F7_BaseBoard\STM32F7_BaseBoard.PrjPcb
Project Filename | STM32F7_BaseBoard.PrjPcb
Variant Name | None
Data-Source Filename | Paralel NOR FLASH.SchDoc
Data-Source Full Path | P:\YILDIZIoT\STM32F7-Base-Board\STM32F7_BaseBoard\Paralel NOR FLASH.SchDoc
Title | NOR BOM for Schematic Document [Paralel NOR FLASH.SchDoc]
Total Quantity | 11
Report Time | 14:38
Report Date | 10.04.2020
Report Date & Tine | 10.04.2020 14:38
Output Name | NOR BOM
Output Type | BOM_PartType
Output Generator Name | BOM
Output Generator Description | Bill of Materials
