yldzmuhammed/STF7-SoM/baseboard/Project Outputs for STM32F7_BaseBoard/BOM/Power BOM-Power.xls

Sheet: BOM Report
Bill of Materials |  |  | Power BOM for Schematic Document [Power.SchDoc]
Source Data From: |  | Power.SchDoc
Project: |  | STM32F7_BaseBoard.PrjPcb
Variant: |  | None
Creation Date: | 10.04.2020 | 14:38
Print Date: | 2020-04-10 | 14:44:14
Production Quantity: | 1
Currency | USD
Comment | Designator | Footprint | Description | Supplier 1 | Supplier Part Number 1 | Manufacturer Part Number | Pricing 1 | Quantity | #Column Name Error:' Price | Supplier Subtotal 1
1uF | C1, C7 | CAP 0603/1608 | Ceramic, SMT Capacitor | Digi-Key | 1276-1182-1-ND | CL10A105KP8NNNC | 1 = 0,10000, 10 = 0,03800, 100 = 0,01680, 500 = 0,01200, 1000 = 0,00943 (USD) | 2 | 0.1 | $0.20
100nF | C2 | CAP 0603/1608 | Ceramic, SMT Capacitor | Digi-Key | 1276-1033-1-ND | CL10B104JB8NNNC | 1 = 0,10000, 10 = 0,05300, 100 = 0,02350, 500 = 0,01680, 1000 = 0,01320 (USD) | 1 | 0.1 | $0.10
10nF | C56 | CAP 0603/1608 | Ceramic, SMT Capacitor | Digi-Key | 399-1092-1-ND | C0603C103J5RACTU | 1 = 0,10000, 10 = 0,05300, 100 = 0,02360, 500 = 0,01682, 1000 = 0,01322 (USD) | 1 | 0.1 | $0.10
4.7uF | C58 | CAP 0603/1608 | Ceramic, SMT Capacitor | Digi-Key | 1276-1907-1-ND | CL10A475MQ8NNNC | 1 = 0,10000, 10 = 0,06300, 100 = 0,02790, 500 = 0,01990, 1000 = 0,01564 (USD) | 1 | 0.1 | $0.10
10uF | C61, C62 | CAP 0603/1608 | Ceramic, SMT Capacitor | Digi-Key | 1276-1119-1-ND | CL10A106MQ8NNNC | 1 = 0,15000, 10 = 0,11000, 100 = 0,05150, 500 = 0,03614, 1000 = 0,02992 (USD) | 2 | 0.15 | $0.30
MIC5353YMT-TR | IC2 | MICREL MLF-6 1.6x1.6MM | Integrated Circuit | Digi-Key | 576-3681-1-ND | MIC5353YMT-TR | 1 = 0,34000, 25 = 0,28000, 100 = 0,26000 (USD) | 1 | 0.34 | $0.34
IRLML6244TRPBF | IC7 | INFINEON SOT-23-3 | MOSFET N-CH 20V 6.3A SOT-23 | Digi-Key | IRLML6244TRPBFCT-ND | IRLML6244TRPBF | 1 = 0,36000, 10 = 0,29400, 25 = 0,26880, 100 = 0,16880, 250 = 0,16688, 500 = 0,15626, 1000 = 0,10625 (USD) | 1 | 0.36 | $0.36
IRLML6402TRPBF | IC9 | INFINEON SOT-23-3 | MOSFET P-CH 20V 3.7A SOT-23 | Digi-Key | IRLML6402PBFCT-ND | IRLML6402TRPBF | 1 = 0,36000, 10 = 0,28800, 25 = 0,26360, 100 = 0,16550, 250 = 0,16368, 500 = 0,15326, 1000 = 0,10421 (USD) | 1 | 0.36 | $0.36
MCP73831T-2ACI/OT | IC10 | MICROCHIP SOT-23-5 OT | Miniature Single-Cell, Fully integrated Li-Ion, Li-Polymer charge management controllers | Digi-Key | MCP73831T-2ACI/OTCT-ND | MCP73831T-2ACI/OT | 1 = 0,56000, 25 = 0,47000, 100 = 0,42000 (USD) | 1 | 0.56 | $0.56
14kR | R7 | RES 0603/1608 | Ceramic, SMT Capacitor | Digi-Key | 311-14.0KHRCT-ND | RC0603FR-0714KL | 1 = 0,10000, 10 = 0,02300, 100 = 0,00940, 1000 = 0,00421, 2500 = 0,00366 (USD) | 1 | 0.1 | $0.10
30MR | R28, R29 | RES 0603/1608 | Ceramic, SMT Capacitor | Digi-Key | 541-30MAHCT-ND | CRCW060330M0JPEAHR | 1 = 0,40000, 10 = 0,28500, 100 = 0,11390, 1000 = 0,05610, 2500 = 0,05198 (USD) | 2 | 0.4 | $0.80
10kR | R30, R31, R32, R33, R35, R36 | RES 0603/1608 | Ceramic, SMT Capacitor | Digi-Key | RNCP0603FTD10K0CT-ND | RNCP0603FTD10K0 | 1 = 0,10000, 10 = 0,06700, 100 = 0,02730, 1000 = 0,01224, 2500 = 0,01063 (USD) | 6 | 0.1 | $0.60
1kR | R34 | RES 0603/1608 | Ceramic, SMT Capacitor | Digi-Key | RHM1.0KDCT-ND | ESR03EZPJ102 | 1 = 0,10000, 10 = 0,08300, 100 = 0,03180, 1000 = 0,01398, 2500 = 0,01207 (USD) | 1 | 0.1 | $0.10
 |  |  |  |  |  |  |  | 21 |  | $4.02
Approved |  | Notes

Sheet: Project Information
Project Full Path | P:\YILDIZIoT\STM32F7-Base-Board\STM32F7_BaseBoard\STM32F7_BaseBoard.PrjPcb
Project Filename | STM32F7_BaseBoard.PrjPcb
Variant Name | None
Data-Source Filename | Power.SchDoc
Data-Source Full Path | P:\YILDIZIoT\STM32F7-Base-Board\STM32F7_BaseBoard\Power.SchDoc
Title | Power BOM for Schematic Document [Power.SchDoc]
Total Quantity | 21
Report Time | 14:38
Report Date | 10.04.2020
Report Date & Tine | 10.04.2020 14:38
Output Name | Power BOM
Output Type | BOM_PartType
Output Generator Name | BOM
Output Generator Description | Bill of Materials
