yldzmuhammed/STF7-SoM/baseboard/Project Outputs for STM32F7_BaseBoard/BOM/QSPI BOM-QSPI FLASH.xls

Sheet: BOM Report
Bill of Materials |  |  | QSPI BOM for Schematic Document [QSPI FLASH.SchDoc]
Source Data From: |  | QSPI FLASH.SchDoc
Project: |  | STM32F7_BaseBoard.PrjPcb
Variant: |  | None
Creation Date: | 10.04.2020 | 14:38
Print Date: | 2020-04-10 | 14:43:20
Production Quantity: | 1
Currency | USD
Comment | Designator | Footprint | Description | Supplier 1 | Supplier Part Number 1 | Manufacturer Part Number | Pricing 1 | Quantity | #Column Name Error:' Price | Supplier Subtotal 1
100nF | C9 | CAP 0603/1608 | Ceramic, SMT Capacitor | Digi-Key | 1276-1033-1-ND | CL10B104JB8NNNC | 1 = 0,10000, 10 = 0,04800, 100 = 0,02160, 500 = 0,01540, 1000 = 0,01210 (USD) | 1 | 0.1 | $0.10
W25Q128JVPIM | IC3 | WINBOND WSON-8 6x5mm |  | Digi-Key | W25Q128JVPIM-ND | W25Q128JVPIM | 1 = 1,47000, 10 = 1,34200, 25 = 1,30640, 50 = 1,29940, 100 = 1,16150, 250 = 1,15808, 500 = 1,14084, 1000 = 1,09189, 5000 = 1,01675 (USD) | 1 | 1.47 | $1.47
10kR | R8 | RES 0603/1608 | Ceramic, SMT Capacitor | Digi-Key | RNCP0603FTD10K0CT-ND | RNCP0603FTD10K0 | 1 = 0,10000, 10 = 0,06700, 100 = 0,02730, 1000 = 0,01224, 2500 = 0,01063 (USD) | 1 | 0.1 | $0.10
 |  |  |  |  |  |  |  | 3 |  | $1.67
Approved |  | Notes

Sheet: Project Information
Project Full Path | P:\YILDIZIoT\STM32F7-Base-Board\STM32F7_BaseBoard\STM32F7_BaseBoard.PrjPcb
Project Filename | STM32F7_BaseBoard.PrjPcb
Variant Name | None
Data-Source Filename | QSPI FLASH.SchDoc
Data-Source Full Path | P:\YILDIZIoT\STM32F7-Base-Board\STM32F7_BaseBoard\QSPI FLASH.SchDoc
Title | QSPI BOM for Schematic Document [QSPI FLASH.SchDoc]
Total Quantity | 3
Report Time | 14:38
Report Date | 10.04.2020
Report Date & Tine | 10.04.2020 14:38
Output Name | QSPI BOM
Output Type | BOM_PartType
Output Generator Name | BOM
Output Generator Description | Bill of Materials
