yldzmuhammed/STF7-SoM/baseboard/Project Outputs for STM32F7_BaseBoard/BOM/SD Card BOM-SD Card.xls

Sheet: BOM Report
Bill of Materials |  |  | SD Card BOM for Schematic Document [SD Card.SchDoc]
Source Data From: |  | SD Card.SchDoc
Project: |  | STM32F7_BaseBoard.PrjPcb
Variant: |  | None
Creation Date: | 10.04.2020 | 14:39
Print Date: | 2020-04-10 | 14:42:56
Production Quantity: | 1
Currency | USD
Comment | Designator | Footprint | Description | Supplier 1 | Supplier Part Number 1 | Manufacturer Part Number | Pricing 1 | Quantity | #Column Name Error:' Price | Supplier Subtotal 1
100nF | C10 | CAP 0603/1608 | Ceramic, SMT Capacitor | Digi-Key | 1276-1033-1-ND | CL10B104JB8NNNC | 1 = 0,10000, 10 = 0,05300, 100 = 0,02350, 500 = 0,01680, 1000 = 0,01320 (USD) | 1 | 0.1 | $0.10
0475710001 | J3 | Molex - 0475710001 | Connector | Digi-Key | WM9731CT-ND | 0475710001 | 1 = 1,030000, 10 = 0,906000, 25 = 0,852400, 50 = 0,817000, 100 = 0,781400, 250 = 0,710400, 500 = 0,639340 (USD) | 1 | 1.03 | $1.03
4.7kR | R9, R10, R11, R12, R13 | RES 0603/1608 | Ceramic, SMT Capacitor | Digi-Key | 311-4.7KGRCT-ND | RC0603JR-074K7L | 1 = 0,10000, 10 = 0,02000, 100 = 0,00810, 1000 = 0,00362, 2500 = 0,00314 (USD) | 5 | 0.1 | $0.50
10kR | R14 | RES 0603/1608 | Ceramic, SMT Capacitor | Digi-Key | RNCP0603FTD10K0CT-ND | RNCP0603FTD10K0 | 1 = 0,10000, 10 = 0,06700, 100 = 0,02730, 1000 = 0,01224, 2500 = 0,01063 (USD) | 1 | 0.1 | $0.10
 |  |  |  |  |  |  |  | 8 |  | $1.73
Approved |  | Notes

Sheet: Project Information
Project Full Path | P:\YILDIZIoT\STM32F7-Base-Board\STM32F7_BaseBoard\STM32F7_BaseBoard.PrjPcb
Project Filename | STM32F7_BaseBoard.PrjPcb
Variant Name | None
Data-Source Filename | SD Card.SchDoc
Data-Source Full Path | P:\YILDIZIoT\STM32F7-Base-Board\STM32F7_BaseBoard\SD Card.SchDoc
Title | SD Card BOM for Schematic Document [SD Card.SchDoc]
Total Quantity | 8
Report Time | 14:39
Report Date | 10.04.2020
Report Date & Tine | 10.04.2020 14:39
Output Name | SD Card BOM
Output Type | BOM_PartType
Output Generator Name | BOM
Output Generator Description | Bill of Materials
