yldzmuhammed/STF7-SoM/baseboard/Project Outputs for STM32F7_BaseBoard/BOM/SDRAM BOM-SDRAM 1.xls

Sheet: BOM Report
Bill of Materials |  |  | SDRAM BOM for Schematic Document [SDRAM 1.SchDoc]
Source Data From: |  | SDRAM 1.SchDoc
Project: |  | STM32F7_BaseBoard.PrjPcb
Variant: |  | None
Creation Date: | 10.04.2020 | 14:39
Print Date: | 2020-04-10 | 14:39:10
Production Quantity: | 1
Currency | USD
Comment | Designator | Footprint | Description | Supplier 1 | Supplier Part Number 1 | Manufacturer Part Number | Pricing 1 | Quantity | #Column Name Error:' Price | Supplier Subtotal 1
100nF | C11, C12, C13, C14, C15, C16, C17 | CAP 0603/1608 | Ceramic, SMT Capacitor | Digi-Key | 1276-1033-1-ND | CL10B104JB8NNNC | 1 = 0,10000, 10 = 0,04800, 100 = 0,02160, 500 = 0,01540, 1000 = 0,01210 (USD) | 7 |  | $0.00
MT48LC16M16A2F4-6A:GTR | IC4 | MICRON VFBGA-54 8X14MM | MT48LC64M4A2 – 16 Meg x 4 x 4 banks MT48LC32M8A2 – 8 Meg x 8 x 4 banks MT48LC16M16A2 – 4 Meg x 16 x 4 banks | Digi-Key | 1450-1350-1-ND | MT48LC16M16A2F4-6A:GTR | 1 = 3,29000, 10 = 2,95500, 25 = 2,90800, 50 = 2,90020, 100 = 2,59150, 250 = 2,50728, 500 = 2,49792, 1000 = 2,32640 (USD) | 1 |  | $0.00
 |  |  |  |  |  |  |  |  |  | $0.00
 |  |  |  |  |  |  |  | 8 |  | $0.00
Approved |  | Notes

Sheet: Project Information
Project Full Path | P:\YILDIZIoT\STM32F7-Base-Board\STM32F7_BaseBoard\STM32F7_BaseBoard.PrjPcb
Project Filename | STM32F7_BaseBoard.PrjPcb
Variant Name | None
Data-Source Filename | SDRAM 1.SchDoc
Data-Source Full Path | P:\YILDIZIoT\STM32F7-Base-Board\STM32F7_BaseBoard\SDRAM 1.SchDoc
Title | SDRAM BOM for Schematic Document [SDRAM 1.SchDoc]
Total Quantity | 8
Report Time | 14:39
Report Date | 10.04.2020
Report Date & Tine | 10.04.2020 14:39
Output Name | SDRAM BOM
Output Type | BOM_PartType
Output Generator Name | BOM
Output Generator Description | Bill of Materials
