yldzmuhammed/STF7-SoM/baseboard/Project Outputs for STM32F7_BaseBoard/BOM/USB BOM-USB.xls

Sheet: BOM Report
Bill of Materials |  |  | USB BOM for Schematic Document [USB.SchDoc]
Source Data From: |  | USB.SchDoc
Project: |  | STM32F7_BaseBoard.PrjPcb
Variant: |  | None
Creation Date: | 10.04.2020 | 14:39
Print Date: | 2020-04-10 | 14:42:21
Production Quantity: | 1
Currency | USD
Comment | Designator | Footprint | Description | Supplier 1 | Supplier Part Number 1 | Manufacturer Part Number | Pricing 1 | Quantity | #Column Name Error:' Price | Supplier Subtotal 1
USB Micro | µUSB1 | FCI USB 10118193-0001LF |  | Digi-Key | 609-4616-1-ND | 10118193-0001LF | 1 = 0,43000, 10 = 0,40500, 25 = 0,36480, 50 = 0,32420, 100 = 0,31070, 250 = 0,28368, 500 = 0,27016 (USD) | 1 | 0.3 | $0.30
20R | R25, R26 | RES 0603/1608 | Ceramic, SMT Capacitor | Digi-Key | P20.0HCT-ND | ERJ3EKF20R0V | 1 = 0,10000, 10 = 0,06500, 100 = 0,02640, 1000 = 0,01186, 2500 = 0,01029 (USD) | 2 | 0.1 | $0.20
4.7kR | R27 | RES 0603/1608 | Ceramic, SMT Capacitor | Digi-Key | 311-4.70KHRCT-ND | RC0603FR-074K7L | 1 = 0,10000, 10 = 0,02400, 100 = 0,00970, 1000 = 0,00437, 2500 = 0,00379 (USD) | 1 | 0.1 | $0.10
 |  |  |  |  |  |  |  | 4 |  | $0.60
Approved |  | Notes

Sheet: Project Information
Project Full Path | P:\YILDIZIoT\STM32F7-Base-Board\STM32F7_BaseBoard\STM32F7_BaseBoard.PrjPcb
Project Filename | STM32F7_BaseBoard.PrjPcb
Variant Name | None
Data-Source Filename | USB.SchDoc
Data-Source Full Path | P:\YILDIZIoT\STM32F7-Base-Board\STM32F7_BaseBoard\USB.SchDoc
Title | USB BOM for Schematic Document [USB.SchDoc]
Total Quantity | 4
Report Time | 14:39
Report Date | 10.04.2020
Report Date & Tine | 10.04.2020 14:39
Output Name | USB BOM
Output Type | BOM_PartType
Output Generator Name | BOM
Output Generator Description | Bill of Materials
