yldzmuhammed/STF7-SoM/expansionboard/hw/Project Outputs for STM32F7_ExpansionBoard/BOM/CAN BOM-CAN.xls

Sheet: BOM Report
Bill of Materials |  |  | CAN BOM for Schematic Document [CAN.SchDoc]
Source Data From: |  | CAN.SchDoc
Project: |  | STM32F7_ExpansionBoard.PrjPcb
Variant: |  | None
Creation Date: | 10.04.2020 | 14:48
Print Date: | 2020-04-10 | 14:50:14
Production Quantity: | 1
Currency | USD
Comment | Designator | Footprint | Description | Supplier 1 | Supplier Part Number 1 | Manufacturer Part Number | Pricing 1 | Quantity | #Column Name Error:' Price | Supplier Subtotal 1
47uF | C1, C3 | CAP 0603/1608 | Ceramic, SMT Capacitor | Digi-Key | 490-13244-1-ND | GRM188C80E476ME05D | 1 = 0,55000, 10 = 0,38500, 100 = 0,25380, 500 = 0,18800, 1000 = 0,15979 (USD) | 2 | 0.55 | $1.10
100nF | C2, C4 | CAP 0603/1608 | Ceramic, SMT Capacitor | Digi-Key | 399-1100-1-ND | C0603C104Z3VACTU | 1 = 0,10000, 10 = 0,03200, 100 = 0,01430, 500 = 0,01020, 1000 = 0,00802 (USD) | 2 | 0.1 | $0.20
AQ24CANFD-02HTG | D1 | ON SEMI SOT-23-3 | TVS DIODE 24V 44V SOT23-3 | Digi-Key | F10993CT-ND | AQ24CANFD-02HTG | 1 = 0,41000, 10 = 0,32900, 25 = 0,30120, 100 = 0,18900, 250 = 0,18692, 500 = 0,17500, 1000 = 0,11900 (USD) | 1 | 0.41 | $0.41
TJA1042T/3/1J | IC1 | NXP SOIC-8 | High Speed CAN, CAN FD Transceiver | Digi-Key | 568-12625-1-ND | TJA1042T/3/1J | 1 = 1,24000, 10 = 1,11300, 25 = 1,05600, 100 = 0,81100, 250 = 0,71668, 500 = 0,67896, 1000 = 0,52808 (USD) | 1 | 1.24 | $1.24
120R | R1 | RES 0603/1608 | Ceramic, SMT Capacitor | Digi-Key | RR08P120DCT-ND | RR0816P-121-D | 1 = 0,11000, 10 = 0,09800, 100 = 0,03760, 1000 = 0,01654, 2500 = 0,01428 (USD) | 1 | 0.11 | $0.11
10kR | R3 | RES 0603/1608 | Ceramic, SMT Capacitor | Digi-Key | RNCP0603FTD10K0CT-ND | RNCP0603FTD10K0 | 1 = 0,10000, 10 = 0,06700, 100 = 0,02730, 1000 = 0,01224, 2500 = 0,01063 (USD) | 1 | 0.1 | $0.10
 |  |  |  |  |  |  |  | 8 |  | $3.16
Approved |  | Notes

Sheet: Project Information
Project Full Path | P:\YILDIZIoT\STM32F7-ExpansionBoard\STM32F7_ExpansionBoard\STM32F7_ExpansionBoard.PrjPcb
Project Filename | STM32F7_ExpansionBoard.PrjPcb
Variant Name | None
Data-Source Filename | CAN.SchDoc
Data-Source Full Path | P:\YILDIZIoT\STM32F7-ExpansionBoard\STM32F7_ExpansionBoard\CAN.SchDoc
Title | CAN BOM for Schematic Document [CAN.SchDoc]
Total Quantity | 8
Report Time | 14:48
Report Date | 10.04.2020
Report Date & Tine | 10.04.2020 14:48
Output Name | CAN BOM
Output Type | BOM_PartType
Output Generator Name | BOM
Output Generator Description | Bill of Materials
