yldzmuhammed/STF7-SoM/expansionboard/hw/Project Outputs for STM32F7_ExpansionBoard/BOM/Expansion BOM-Expansion.xls

Sheet: BOM Report
Bill of Materials |  |  | Expansion BOM for Schematic Document [Expansion.SchDoc]
Source Data From: |  | Expansion.SchDoc
Project: |  | STM32F7_ExpansionBoard.PrjPcb
Variant: |  | None
Creation Date: | 10.04.2020 | 14:48
Print Date: | 2020-04-10 | 14:50:25
Production Quantity: | 1
Currency | USD
Comment | Designator | Footprint | Description | Supplier 1 | Supplier Part Number 1 | Manufacturer Part Number | Pricing 1 | Quantity | #Column Name Error:' Price | Supplier Subtotal 1
BM24-10DP/2-0.35V(53) | J5, J6, J7 | HIROSE BM2410DP | Board to Board Connector | Digi-Key | H124923CT-ND | BM24-10DP/2-0.35V(53) | 1 = 1,08000, 10 = 0,95400, 25 = 0,89760, 50 = 0,86020, 100 = 0,82280, 250 = 0,74800, 500 = 0,67320 (USD) | 3 | 1.08 | $3.24
ALQ105 | K1 | ALQ105 | Relay or Contactor | Digi-Key | 255-3565-ND | ALQ105 | 1 = 1,22000, 10 = 1,14800, 25 = 1,02000, 50 = 0,96900, 100 = 0,91800, 250 = 0,81600, 500 = 0,76500, 1000 = 0,71400, 5000 = 0,68850 (USD) | 1 | 1.22 | $1.22
1kR | R24 | RES 0603/1608 | Ceramic, SMT Capacitor | Digi-Key | RHM1.0KDCT-ND | ESR03EZPJ102 | 1 = 0,10000, 10 = 0,08300, 100 = 0,03180, 1000 = 0,01398, 2500 = 0,01207 (USD) | 1 | 0.1 | $0.10
10kR | R25 | RES 0603/1608 | Ceramic, SMT Capacitor | Digi-Key | RNCP0603FTD10K0CT-ND | RNCP0603FTD10K0 | 1 = 0,10000, 10 = 0,06700, 100 = 0,02730, 1000 = 0,01224, 2500 = 0,01063 (USD) | 1 | 0.1 | $0.10
 |  |  |  |  |  |  |  | 6 |  | $4.66
Approved |  | Notes

Sheet: Project Information
Project Full Path | P:\YILDIZIoT\STM32F7-ExpansionBoard\STM32F7_ExpansionBoard\STM32F7_ExpansionBoard.PrjPcb
Project Filename | STM32F7_ExpansionBoard.PrjPcb
Variant Name | None
Data-Source Filename | Expansion.SchDoc
Data-Source Full Path | P:\YILDIZIoT\STM32F7-ExpansionBoard\STM32F7_ExpansionBoard\Expansion.SchDoc
Title | Expansion BOM for Schematic Document [Expansion.SchDoc]
Total Quantity | 6
Report Time | 14:48
Report Date | 10.04.2020
Report Date & Tine | 10.04.2020 14:48
Output Name | Expansion BOM
Output Type | BOM_PartType
Output Generator Name | BOM
Output Generator Description | Bill of Materials
