yldzmuhammed/STF7-SoM/expansionboard/hw/Project Outputs for STM32F7_ExpansionBoard/BOM/RS485 BOM-RS485.xls

Sheet: BOM Report
Bill of Materials |  |  | RS485 BOM for Schematic Document [RS485.SchDoc]
Source Data From: |  | RS485.SchDoc
Project: |  | STM32F7_ExpansionBoard.PrjPcb
Variant: |  | None
Creation Date: | 10.04.2020 | 14:49
Print Date: | 2020-04-10 | 14:50:00
Production Quantity: | 1
Currency | USD
Comment | Designator | Footprint | Description | Supplier 1 | Supplier Part Number 1 | Manufacturer Part Number | Pricing 1 | Quantity | Price | Supplier Subtotal 1
100nF | C25 | CAP 0603/1608 | Capacitor, Ceramic | Digi-Key | 1276-1857-1-ND | CL10A104KA8NNNC | 1 = 0,10000, 10 = 0,04600, 100 = 0,02070, 500 = 0,01478, 1000 = 0,01162 (USD) | 1 | 0.1 | $0.10
CDSOT23-SM712 | D3 | sc70-3 | Dual-line Transil™, transient voltage suppressor (TVS) | Digi-Key | CDSOT23-SM712CT-ND | CDSOT23-SM712 | 1 = 1,70000, 10 = 1,50900, 25 = 1,36280, 100 = 1,19240, 250 = 1,04636, 500 = 0,92468, 1000 = 0,73001 (USD) | 1 | 1.7 | $1.70
SN75ALS176DR | IC6 | TI SOIC-8 D | IC TRANSCEIVER HALF 1/1 8SOIC | Digi-Key | 296-14966-1-ND | SN75ALS176DR | 1 = 0,99000, 10 = 0,88500, 25 = 0,84000, 100 = 0,69000, 250 = 0,64500, 500 = 0,57000, 1000 = 0,45000 (USD) | 1 | 0.99 | $0.99
120R | R30 | RES 0603/1608 | Ceramic, SMT Capacitor | Digi-Key | RR08P120DCT-ND | RR0816P-121-D | 1 = 0,11000, 10 = 0,09800, 100 = 0,03760, 1000 = 0,01654, 2500 = 0,01428 (USD) | 1 | 0.11 | $0.11
10R | R31, R32 | RES 0603/1608 | Ceramic, SMT Capacitor | Digi-Key | RHM10DCT-ND | ESR03EZPJ100 | 1 = 0,10000, 10 = 0,08700, 100 = 0,03330, 1000 = 0,01464, 2500 = 0,01264 (USD) | 2 | 0.1 | $0.20
10kR | R33 | RES 0603/1608 | Ceramic, SMT Capacitor | Digi-Key | RNCP0603FTD10K0CT-ND | RNCP0603FTD10K0 | 1 = 0,10000, 10 = 0,06700, 100 = 0,02730, 1000 = 0,01224, 2500 = 0,01063 (USD) | 1 | 0.1 | $0.10
 |  |  |  |  |  |  |  | 7 |  | $3.20
Approved |  | Notes

Sheet: Project Information
Project Full Path | P:\YILDIZIoT\STM32F7-ExpansionBoard\STM32F7_ExpansionBoard\STM32F7_ExpansionBoard.PrjPcb
Project Filename | STM32F7_ExpansionBoard.PrjPcb
Variant Name | None
Data-Source Filename | RS485.SchDoc
Data-Source Full Path | P:\YILDIZIoT\STM32F7-ExpansionBoard\STM32F7_ExpansionBoard\RS485.SchDoc
Title | RS485 BOM for Schematic Document [RS485.SchDoc]
Total Quantity | 7
Report Time | 14:49
Report Date | 10.04.2020
Report Date & Tine | 10.04.2020 14:49
Output Name | RS485 BOM
Output Type | BOM_PartType
Output Generator Name | BOM
Output Generator Description | Bill of Materials
