yldzmuhammed/STF7-SoM/doc/Pinout.xlsx

Sheet: Pinout
Pin | Name | Type | Periph | SubGrp | Signal | Label | AF0 | AF1 | AF2 | AF3 | AF4 | AF5 | AF6 | AF7 | AF8 | AF9 | AF10 | AF11 | AF12 | AF13 | AF14
A01 | PE04 | I/O | FMC | ADDRESS | FMC_A20 | FMC_A20 | SYS_TRACED1 |  |  |  |  | SPI4_NSS | SAI1_FS_A |  |  |  |  |  | FMC_A20 | DCMI_D4 | LTDC_B0
A02 | PE03 | I/O | FMC | ADDRESS | FMC_A19 | FMC_A19 | SYS_TRACED0 |  |  |  |  |  | SAI1_SD_B |  |  |  |  |  | FMC_A19
A03 | PE02 | I/O | QSPI | DATA | QUADSPI_BK1_IO2 | QSP_IO2 | SYS_TRACECLK |  |  |  |  | SPI4_SCK | SAI1_MCLK_A |  |  | QUADSPI_BK1_IO2 |  | ETH_TXD3 | FMC_A23
N02 | PA01 | I/O | ETHERNET | CLOCK | ETH_REF_CLK | ETH_REF_CLK |  | TIM2_CH2 | TIM5_CH2 |  |  |  |  | USART2_DE/USART2_RTS | UART4_RX | QUADSPI_BK1_IO3 | SAI2_MCLK_B | ETH_REF_CLK/ETH_RX_CLK |  |  | LTDC_R2
A05 | PE01 | I/O | FMC | CONTROL | FMC_NBL1 | FMC_NBL1 |  |  |  | LPTIM1_IN2 |  |  |  |  | UART8_TX |  |  |  | FMC_NBL1 | DCMI_D3
A06 | PE00 | I/O | FMC | CONTROL | FMC_NBL0 | FMC_NBL0 |  |  | TIM4_ETR | LPTIM1_ETR |  |  |  |  | UART8_RX |  | SAI2_MCLK_A |  | FMC_NBL0 | DCMI_D2
A07 | PB08 | I/O | I2C | CLOCK | I2C1_SCL | DCMI_SCL |  |  | TIM4_CH3 | TIM10_CH1 | I2C1_SCL |  |  |  |  | CAN1_RX |  | ETH_TXD3 | SDMMC1_D4 | DCMI_D6 | LTDC_B6
A08 | PB05 | I/O | SPI | DATA | SPI1_MOSI | DCMI_MOSI |  |  | TIM3_CH2 |  | I2C1_SMBA | I2S1_SD/SPI1_MOSI | I2S3_SD/SPI3_MOSI |  |  | CAN2_RX | USB_OTG_HS_ULPI_D7 | ETH_PPS_OUT | FMC_SDCKE1 | DCMI_D10
A09 | PB04 | I/O | SPI | DATA | SPI1_MISO | DCMI_MISO | SYS_JTRST |  | TIM3_CH1 |  |  | SPI1_MISO | SPI3_MISO | I2S2_WS/SPI2_NSS
A10 | PB03 | I/O | JTAG | DATA | SYS_JTDO-SWO | SWO | SYS_JTDO-SWO | TIM2_CH2 |  |  |  | I2S1_CK/SPI1_SCK | I2S3_CK/SPI3_SCK
A11 | PD07 | I/O | FMC | CONTROL | FMC_NE1 | FMC_NE |  |  |  |  |  |  |  | USART2_CK | SPDIFRX_IN0 |  |  |  | FMC_NE1
A12 | PC12 | I/O | SDCARD | CLOCK | SDMMC1_CK | SD_CK | SYS_TRACED3 |  |  |  |  |  | I2S3_SD/SPI3_MOSI | USART3_CK | UART5_TX |  |  |  | SDMMC1_CK | DCMI_D9
P02 | PA02 | I/O | ETHERNET | CONTROL | ETH_MDIO | ETH_MDIO |  | TIM2_CH3 | TIM5_CH3 | TIM9_CH1 |  |  |  | USART2_TX | SAI2_SCK_B |  |  | ETH_MDIO |  |  | LTDC_R1
A14 | PA14 | I/O | JTAG | CLOCK | SYS_JTCK-SWCLK | SWCLK | SYS_JTCK-SWCLK
A15 | PA13 | I/O | JTAG | DATA | SYS_JTMS-SWDIO | SWDIO | SYS_JTMS-SWDIO
B01 | PE05 | I/O | FMC | ADDRESS | FMC_A21 | FMC_A21 | SYS_TRACED2 |  |  | TIM9_CH1 |  | SPI4_MISO | SAI1_SCK_A |  |  |  |  |  | FMC_A21 | DCMI_D6 | LTDC_G0
B02 | PE06 | I/O | DCMI | DATA | DCMI_D7 | DCMI_D07 | SYS_TRACED3 | TIM1_BKIN2 |  | TIM9_CH2 |  | SPI4_MOSI | SAI1_SD_A |  |  |  | SAI2_MCLK_B |  | FMC_A22 | DCMI_D7 | LTDC_G1
R03 | PA07 | I/O | ETHERNET | CONTROL | ETH_CRS_DV | ETH_CRS_DV |  | TIM1_CH1N | TIM3_CH2 | TIM8_CH1N |  | I2S1_SD/SPI1_MOSI |  |  |  | TIM14_CH1 |  | ETH_CRS_DV/ETH_RX_DV | FMC_SDNWE
F15 | PA08 | I/O | I2C | CLOCK | I2C3_SCL | EXP_SCL | RCC_MCO_1 | TIM1_CH1 |  | TIM8_BKIN2 | I2C3_SCL |  |  | USART1_CK |  |  | USB_OTG_FS_SOF |  |  |  | LTDC_R6
B05 | PB07 | I/O | I2C | DATA | I2C1_SDA | DCMI_SDA |  |  | TIM4_CH2 |  | I2C1_SDA |  |  | USART1_RX |  |  |  |  | FMC_NL | DCMI_VSYNC
B06 | PB06 | I/O | QSPI | CONTROL | QUADSPI_BK1_NCS | QSP_NCS |  |  | TIM4_CH1 | CEC | I2C1_SCL |  |  | USART1_TX |  | CAN2_TX | QUADSPI_BK1_NCS |  | FMC_SDNE1 | DCMI_D5
B07 | PG15 | I/O | FMC | CONTROL | FMC_SDNCAS | FMC_SDNCAS |  |  |  |  |  |  |  |  | USART6_CTS |  |  |  | FMC_SDNCAS | DCMI_D13
E15 | PA09 | I/O | UART | DATA | USART1_TX | WiFi_TX |  | TIM1_CH2 |  |  | I2C3_SMBA | I2S2_CK/SPI2_SCK |  | USART1_TX |  |  |  |  |  | DCMI_D0
B09 | PJ13 | I/O | LTDC | BLUE | LTDC_B1 | LTDC_B1 |  |  |  |  |  |  |  |  |  |  |  |  |  |  | LTDC_B1
B10 | PJ12 | I/O | LTDC | BLUE | LTDC_B0 | LTDC_B0 |  |  |  |  |  |  |  |  |  |  |  |  |  |  | LTDC_B0
B11 | PD06 | I/O | FMC | CONTROL | FMC_NWAIT | FMC_NWAIT |  |  |  |  |  | I2S3_SD/SPI3_MOSI | SAI1_SD_A | USART2_RX |  |  |  |  | FMC_NWAIT | DCMI_D10 | LTDC_B2
B12 | PD00 | I/O | FMC | DATA | FMC_D02 | FMC_D02 |  |  |  |  |  |  |  |  |  | CAN1_RX |  |  | FMC_D2/FMC_DA2
B13 | PC11 | I/O | SDCARD | DATA | SDMMC1_D3 | SD_D3 |  |  |  |  |  |  | SPI3_MISO | USART3_RX | UART4_RX | QUADSPI_BK2_NCS |  |  | SDMMC1_D3 | DCMI_D4
B14 | PC10 | I/O | SDCARD | DATA | SDMMC1_D2 | SD_D2 |  |  |  |  |  |  | I2S3_CK/SPI3_SCK | USART3_TX | UART4_TX | QUADSPI_BK1_IO1 |  |  | SDMMC1_D2 | DCMI_D8 | LTDC_R2
D15 | PA10 | I/O | UART | DATA | USART1_RX | WiFi_RX |  | TIM1_CH3 |  |  |  |  |  | USART1_RX |  |  | USB_OTG_FS_ID |  |  | DCMI_D1
C01 | VBAT | Power
C02 | PI08 | Output | GPIO | OUTPUT | GPIO_Output | LTDC_DISP
C03 | PI04 | I/O | DCMI | DATA | DCMI_D5 | DCMI_D05 |  |  |  | TIM8_BKIN |  |  |  |  |  |  | SAI2_MCLK_A |  | FMC_NBL2 | DCMI_D5 | LTDC_B4
C04 | PK07 | I/O | LTDC | CONTROL | LTDC_DE | LTDC_DE |  |  |  |  |  |  |  |  |  |  |  |  |  |  | LTDC_DE
C05 | PK06 | I/O | LTDC | BLUE | LTDC_B7 | LTDC_B7 |  |  |  |  |  |  |  |  |  |  |  |  |  |  | LTDC_B7
C06 | PK05 | I/O | LTDC | BLUE | LTDC_B6 | LTDC_B6 |  |  |  |  |  |  |  |  |  |  |  |  |  |  | LTDC_B6
C15 | PA11 | I/O | UART | CONTROL | USART1_CTS | WiFi_CTS |  | TIM1_CH4 |  |  |  |  |  | USART1_CTS |  | CAN1_RX | USB_OTG_FS_DM |  |  |  | LTDC_R4
C08 | PG10 | I/O | DCMI | DATA | DCMI_D2 | DCMI_D02 |  |  |  |  |  |  |  |  |  | LTDC_G3 | SAI2_SD_B |  | FMC_NE3 | DCMI_D2 | LTDC_B2
C09 | PJ14 | I/O | LTDC | BLUE | LTDC_B2 | LTDC_B2 |  |  |  |  |  |  |  |  |  |  |  |  |  |  | LTDC_B2
C10 | PD05 | I/O | FMC | CONTROL | FMC_NWE | FMC_NWE |  |  |  |  |  |  |  | USART2_TX |  |  |  |  | FMC_NWE
B15 | PA12 | I/O | UART | CONTROL | USART1_RTS | WiFi_RTS |  | TIM1_ETR |  |  |  |  |  | USART1_DE/USART1_RTS | SAI2_FS_B | CAN1_TX | USB_OTG_FS_DP |  |  |  | LTDC_R5
C12 | PD01 | I/O | FMC | DATA | FMC_D03 | FMC_D03 |  |  |  |  |  |  |  |  |  | CAN1_TX |  |  | FMC_D3/FMC_DA3
A13 | PA15 | Output | GPIO | OUTPUT | GPIO_Output | WiFi_PWE | SYS_JTDI | TIM2_CH1/TIM2_ETR |  |  | CEC | I2S1_WS/SPI1_NSS | I2S3_WS/SPI3_NSS |  | UART4_DE/UART4_RTS
R04 | PB01 | Output | GPIO | OUTPUT | GPIO_Output | RS485_DE |  | TIM1_CH3N | TIM3_CH4 | TIM8_CH3N |  |  |  |  |  | LTDC_R6 | USB_OTG_HS_ULPI_D2 | ETH_RXD3
B04 | PB09 | I/O | CAN | DATA | CAN1_TX | CAN_TX |  |  | TIM4_CH4 | TIM11_CH1 | I2C1_SDA | I2S2_WS/SPI2_NSS |  |  |  | CAN1_TX |  |  | SDMMC1_D5 | DCMI_D7 | LTDC_B7
D01 | PC13 | I/O |  |  |  | EXP_GPIO3
D02 | PF00 | I/O | FMC | ADDRESS | FMC_A00 | FMC_A00 |  |  |  |  | I2C2_SDA |  |  |  |  |  |  |  | FMC_A0
D03 | PI05 | I/O | DCMI | CONTROL | DCMI_VSYNC | DCMI_VSYNC |  |  |  | TIM8_CH1 |  |  |  |  |  |  | SAI2_SCK_A |  | FMC_NBL3 | DCMI_VSYNC | LTDC_B5
D04 | PI07 | Output | GPIO | OUTPUT | GPIO_Output | DCMI_PWRE |  |  |  | TIM8_CH3 |  |  |  |  |  |  | SAI2_FS_A |  | FMC_D29 | DCMI_D7 | LTDC_B7
D05 | PI10 | I/O | LTDC | CONTROL | LTDC_HSYNC | LTDC_HSYNC |  |  |  |  |  |  |  |  |  |  |  | ETH_RX_ER | FMC_D31 |  | LTDC_HSYNC
D06 | PI06 | I/O | DCMI | DATA | DCMI_D6 | DCMI_D06 |  |  |  | TIM8_CH2 |  |  |  |  |  |  | SAI2_SD_A |  | FMC_D28 | DCMI_D6 | LTDC_B6
D07 | PK04 | I/O | LTDC | BLUE | LTDC_B5 | LTDC_B5 |  |  |  |  |  |  |  |  |  |  |  |  |  |  | LTDC_B5
D08 | PK03 | I/O | LTDC | BLUE | LTDC_B4 | LTDC_B4 |  |  |  |  |  |  |  |  |  |  |  |  |  |  | LTDC_B4
D09 | PG09 | I/O |  |  |  |  |  |  |  |  |  |  |  | SPDIFRX_IN3 | USART6_RX | QUADSPI_BK2_IO2 | SAI2_FS_B |  | FMC_NCE/FMC_NE2 | DCMI_VSYNC
D10 | PJ15 | I/O | LTDC | BLUE | LTDC_B3 | LTDC_B3 |  |  |  |  |  |  |  |  |  |  |  |  |  |  | LTDC_B3
D11 | PD04 | I/O | FMC | CONTROL | FMC_NOE | FMC_NOE |  |  |  |  |  |  |  | USART2_DE/USART2_RTS |  |  |  |  | FMC_NOE
D12 | PD02 | I/O | SDCARD | CONTROL | SDMMC1_CMD | SD_CMD | SYS_TRACED2 |  | TIM3_ETR |  |  |  |  |  | UART5_RX |  |  |  | SDMMC1_CMD | DCMI_D11
D13 | PH15 | I/O | LTDC | GREEN | LTDC_G4 | LTDC_G4 |  |  |  | TIM8_CH3N |  |  |  |  |  |  |  |  | FMC_D23 | DCMI_D11 | LTDC_G4
D14 | PI01 | I/O | LTDC | GREEN | LTDC_G6 | LTDC_G6 |  |  |  | TIM8_BKIN2 |  | I2S2_CK/SPI2_SCK |  |  |  |  |  |  | FMC_D25 | DCMI_D8 | LTDC_G6
P12 | PB10 | I/O | UART | DATA | USART3_TX | RS485_TX |  | TIM2_CH3 |  |  | I2C2_SCL | I2S2_CK/SPI2_SCK |  | USART3_TX |  |  | USB_OTG_HS_ULPI_D3 | ETH_RX_ER |  |  | LTDC_G4
E01 | PC14 | I/O | OSC | CLOCK | RCC_OSC32_IN | LS_OSC1
E02 | PF01 | I/O | FMC | ADDRESS | FMC_A01 | FMC_A01 |  |  |  |  | I2C2_SCL |  |  |  |  |  |  |  | FMC_A1
E03 | PI12 | Output | GPIO | OUTPUT | GPIO_Output | DCMI_RST |  |  |  |  |  |  |  |  |  |  |  |  |  |  | LTDC_HSYNC
R13 | PB11 | I/O | UART | DATA | USART3_RX | RS485_RX |  | TIM2_CH4 |  |  | I2C2_SDA |  |  | USART3_RX |  |  | USB_OTG_HS_ULPI_D4 | ETH_TX_EN |  |  | LTDC_G5
E05 | PDR_ON | Reset
E06 | BOOT0 | Boot
E07 | VDD | Power
E08 | VDD | Power
E09 | VDD | Power
E10 | VDD | Power
E11 | VCAP_2 | Power
E12 | PH13 | I/O | LTDC | GREEN | LTDC_G2 | LTDC_G2 |  |  |  | TIM8_CH1N |  |  |  |  |  | CAN1_TX |  |  | FMC_D21 |  | LTDC_G2
E13 | PH14 | I/O | DCMI | DATA | DCMI_D4 | DCMI_D04 |  |  |  | TIM8_CH2N |  |  |  |  |  |  |  |  | FMC_D22 | DCMI_D4 | LTDC_G3
E14 | PI00 | I/O | LTDC | GREEN | LTDC_G5 | LTDC_G5 |  |  | TIM5_CH4 |  |  | I2S2_WS/SPI2_NSS |  |  |  |  |  |  | FMC_D24 | DCMI_D13 | LTDC_G5
L13 | PB12 | I/O | ETHERNET | DATA | ETH_TXD0 | ETH_TXD0 |  | TIM1_BKIN |  |  | I2C2_SMBA | I2S2_WS/SPI2_NSS |  | USART3_CK |  | CAN2_RX | USB_OTG_HS_ULPI_D5 | ETH_TXD0 | USB_OTG_HS_ID
F01 | PC15 | I/O | OSC | CLOCK | RCC_OSC32_OUT | LS_OSC2
F02 | VSS | Power
F03 | PI11 | Input | GPIO | INPUT | GPIO_Input | VBATT_CHSTAT |  |  |  |  |  |  |  |  |  |  | USB_OTG_HS_ULPI_DIR
F04 | VDD | Power
F05 | VDD | Power
F06 | VSS | Power
F07 | VSS | Power
F08 | VSS | Power
F09 | VSS | Power
F10 | VSS | Power
F11 | VDD | Power
F12 | PK01 | Output | GPIO | OUTPUT | GPIO_Output | LTDC_TPRST |  |  |  |  |  |  |  |  |  |  |  |  |  |  | LTDC_G6
F13 | PK02 | I/O | LTDC | GREEN | LTDC_G7 | LTDC_G7 |  |  |  |  |  |  |  |  |  |  |  |  |  |  | LTDC_G7
F14 | PC09 | I/O | SDCARD | DATA | SDMMC1_D1 | SD_D1 | RCC_MCO_2 |  | TIM3_CH4 | TIM8_CH4 | I2C3_SDA | I2S_CKIN |  | UART5_CTS |  | QUADSPI_BK1_IO0 |  |  | SDMMC1_D1 | DCMI_D3
K14 | PB13 | I/O | ETHERNET | DATA | ETH_TXD1 | ETH_TXD1 |  | TIM1_CH1N |  |  |  | I2S2_CK/SPI2_SCK |  | USART3_CTS |  | CAN2_TX | USB_OTG_HS_ULPI_D6 | ETH_TXD1
G01 | PH00 | I/O | OSC | CLOCK | RCC_OSC_IN | HS_OSC1
G02 | PF02 | I/O | FMC | ADDRESS | FMC_A02 | FMC_A02 |  |  |  |  | I2C2_SMBA |  |  |  |  |  |  |  | FMC_A2
G03 | PI13 | I/O | LTDC | CONTROL | LTDC_VSYNC | LTDC_VSYNC |  |  |  |  |  |  |  |  |  |  |  |  |  |  | LTDC_VSYNC
G04 | PI15 | I/O | LTDC | RED | LTDC_R0 | LTDC_R0 |  |  |  |  |  |  |  |  |  |  |  |  |  |  | LTDC_R0
G05 | VDD | Power
G06 | VSS | Power
G10 | VSS | Power
G11 | VDDUSB | Power
G12 | PJ11 | Input | GPIO | INPUT | GPIO_Input | LTDC_TPIRQ |  |  |  |  |  |  |  |  |  |  |  |  |  |  | LTDC_G4
M03 | PC01 | I/O | ETHERNET | CONTROL | ETH_MDC | ETH_MDC | SYS_TRACED0 |  |  |  |  | I2S2_SD/SPI2_MOSI | SAI1_SD_A |  |  |  |  | ETH_MDC
G14 | PC08 | I/O | SDCARD | DATA | SDMMC1_D0 | SD_D0 | SYS_TRACED1 |  | TIM3_CH3 | TIM8_CH3 |  |  |  | UART5_DE/UART5_RTS | USART6_CK |  |  |  | SDMMC1_D0 | DCMI_D2
M04 | PC02 | Input | GPIO | INPUT | GPIO_Input | RMII_RXER |  |  |  |  |  | SPI2_MISO |  |  |  |  | USB_OTG_HS_ULPI_DIR | ETH_TXD2 | FMC_SDNE0
H01 | PH01 | I/O | OSC | CLOCK | RCC_OSC_OUT | HS_OSC2
H02 | PF03 | I/O | FMC | ADDRESS | FMC_A03 | FMC_A03 |  |  |  |  |  |  |  |  |  |  |  |  | FMC_A3
H03 | PI14 | I/O | LTDC | CLOK | LTDC_CLK | LTDC_CLK |  |  |  |  |  |  |  |  |  |  |  |  |  |  | LTDC_CLK
H04 | PH04 | I/O | I2C | CLOCK | I2C2_SCL | LTDC_SCL |  |  |  |  | I2C2_SCL |  |  |  |  |  | USB_OTG_HS_ULPI_NXT
H05 | VDD | Power
H06 | VSS | Power
H10 | VSS | Power
H11 | VDD | Power
H12 | PJ08 | I/O | LTDC | GREEN | LTDC_G1 | LTDC_G1 |  |  |  |  |  |  |  |  |  |  |  |  |  |  | LTDC_G1
H13 | PJ10 | I/O | LTDC | GREEN | LTDC_G3 | LTDC_G3 |  |  |  |  |  |  |  |  |  |  |  |  |  |  | LTDC_G3
H14 | PG08 | I/O | FMC | CLOCK | FMC_SDCLK | FMC_SDCLK |  |  |  |  |  | SPI6_NSS |  | SPDIFRX_IN2 | USART6_DE/USART6_RTS |  |  | ETH_PPS_OUT | FMC_SDCLK
H15 | PC06 | I/O | DCMI | DATA | DCMI_D0 | DCMI_D00 |  |  | TIM3_CH1 | TIM8_CH1 |  | I2S2_MCK |  |  | USART6_TX |  |  |  | SDMMC1_D6 | DCMI_D0 | LTDC_HSYNC
J01 | NRST | Reset
J02 | PF04 | I/O | FMC | ADDRESS | FMC_A04 | FMC_A04 |  |  |  |  |  |  |  |  |  |  |  |  | FMC_A4
J03 | PH05 | I/O | I2C | DATA | I2C2_SDA | LTDC_SDA |  |  |  |  | I2C2_SDA | SPI5_NSS |  |  |  |  |  |  | FMC_SDNWE
J04 | PH03 | I/O | FMC | CONTROL | FMC_SDNE0 | FMC_SDNE0 |  |  |  |  |  |  |  |  |  | QUADSPI_BK2_IO1 | SAI2_MCLK_B | ETH_COL | FMC_SDNE0 |  | LTDC_R1
J05 | VDD | Power
J06 | VSS | Power
J10 | VSS | Power
J11 | VDD | Power
J12 | PJ07 | I/O | LTDC | GREEN | LTDC_G0 | LTDC_G0 |  |  |  |  |  |  |  |  |  |  |  |  |  |  | LTDC_G0
N05 | PC04 | I/O | ETHERNET | DATA | ETH_RXD0 | ETH_RXD0 |  |  |  |  |  | I2S1_MCK |  |  | SPDIFRX_IN2 |  |  | ETH_RXD0 | FMC_SDNE0
P05 | PC05 | I/O | ETHERNET | DATA | ETH_RXD1 | ETH_RXD1 |  |  |  |  |  |  |  |  | SPDIFRX_IN3 |  |  | ETH_RXD1 | FMC_SDCKE0
J15 | PG06 | I/O | LTDC | RED | LTDC_R7 | LTDC_R7 |  |  |  |  |  |  |  |  |  |  |  |  |  | DCMI_D12 | LTDC_R7
K01 | PF07 | I/O | TIMER | PWM | TIM11_CH1 | LTDC_BL |  |  |  | TIM11_CH1 |  | SPI5_SCK | SAI1_MCLK_B |  | UART7_TX | QUADSPI_BK1_IO2
K02 | PF06 | I/O | QSPI | DATA | QUADSPI_BK1_IO3 | QSP_IO3 |  |  |  | TIM10_CH1 |  | SPI5_NSS | SAI1_SD_B |  | UART7_RX | QUADSPI_BK1_IO3
K03 | PF05 | I/O | FMC | ADDRESS | FMC_A05 | FMC_A05 |  |  |  |  |  |  |  |  |  |  |  |  | FMC_A5
K04 | PH02 | I/O | FMC | CONTROL | FMC_SDCKE0 | FMC_SDCKE0 |  |  |  | LPTIM1_IN2 |  |  |  |  |  | QUADSPI_BK2_IO0 | SAI2_SCK_B | ETH_CRS | FMC_SDCKE0 |  | LTDC_R0
K05 | VDD | Power
K06 | VSS | Power
K07 | VSS | Power
K08 | VSS | Power
K09 | VSS | Power
K10 | VSS | Power
K11 | VDD | Power
G15 | PC07 | I/O | UART | DATA | USART6_RX | GSM_RX |  |  | TIM3_CH2 | TIM8_CH2 |  |  | I2S3_MCK |  | USART6_RX |  |  |  | SDMMC1_D7 | DCMI_D1 | LTDC_G6
K13 | PD15 | I/O | FMC | DATA | FMC_D01 | FMC_D01 |  |  | TIM4_CH4 |  |  |  |  |  | UART8_DE/UART8_RTS |  |  |  | FMC_D1/FMC_DA1
C11 | PD03 | I/O | SPI | CLOCK | SPI2_SCK | WiFi_SCK |  |  |  |  |  | I2S2_CK/SPI2_SCK |  | USART2_CTS |  |  |  |  | FMC_CLK | DCMI_D5 | LTDC_G7
K15 | PD10 | I/O | FMC | DATA | FMC_D15 | FMC_D15 |  |  |  |  |  |  |  | USART3_CK |  |  |  |  | FMC_D15/FMC_DA15 |  | LTDC_B3
L01 | PF10 | I/O |  |  |  | EXP_GPIO0 |  |  |  |  |  |  |  |  |  |  |  |  |  | DCMI_D11 | LTDC_DE
L02 | PF09 | I/O | QSPI | DATA | QUADSPI_BK1_IO1 | QSP_IO1 |  |  |  |  |  | SPI5_MOSI | SAI1_FS_B |  | UART7_CTS | TIM14_CH1 | QUADSPI_BK1_IO1
L03 | PF08 | I/O | QSPI | DATA | QUADSPI_BK1_IO0 | QSP_IO0 |  |  |  |  |  | SPI5_MISO | SAI1_SCK_B |  | UART7_DE/UART7_RTS | TIM13_CH1 | QUADSPI_BK1_IO0
L04 | PC03 | I/O |  |  |  | EXP_GPIO1 |  |  |  |  |  | I2S2_SD/SPI2_MOSI |  |  |  |  | USB_OTG_HS_ULPI_NXT | ETH_TX_CLK | FMC_SDCKE0
L05 | BYPASS_REG | Reset
L06 | VSS | Power
L07 | VDD | Power
L08 | VDD | Power
L09 | VDD | Power
L10 | VDD | Power
L11 | VCAP_1 | Power
L12 | PD14 | I/O | FMC | DATA | FMC_D00 | FMC_D00 |  |  | TIM4_CH3 |  |  |  |  |  | UART8_CTS |  |  |  | FMC_D0/FMC_DA0
J14 | PG07 | Output | GPIO | OUTPUT | GPIO_Output | GSM_DCD |  |  |  |  |  |  |  |  | USART6_CK |  |  |  | FMC_INT | DCMI_D13 | LTDC_CLK
L14 | PD09 | I/O | FMC | DATA | FMC_D14 | FMC_D14 |  |  |  |  |  |  |  | USART3_RX |  |  |  |  | FMC_D14/FMC_DA14
L15 | PD08 | I/O | FMC | DATA | FMC_D13 | FMC_D13 |  |  |  |  |  |  |  | USART3_TX | SPDIFRX_IN1 |  |  |  | FMC_D13/FMC_DA13
M01 | VSSA | Power
M02 | PC00 | I/O | FMC | CONTROL | FMC_SDNWE | FMC_SDNWE |  |  |  |  |  |  |  |  | SAI2_FS_B |  | USB_OTG_HS_ULPI_STP |  | FMC_SDNWE |  | LTDC_R5
B08 | PG11 | I/O | ETHERNET | DATA | ETH_TX_EN | ETH_TX_EN |  |  |  |  |  |  |  | SPDIFRX_IN0 |  |  |  | ETH_TX_EN |  | DCMI_D3 | LTDC_B3
C07 | PG12 | I/O | UART | CONTROL | USART6_RTS | GSM_RTS |  |  |  | LPTIM1_IN1 |  | SPI6_MISO |  | SPDIFRX_IN1 | USART6_DE/USART6_RTS | LTDC_B4 |  |  | FMC_NE4 |  | LTDC_B1
M05 | PB02 | I/O | QSPI | CLOCK | QUADSPI_CLK | QSP_CLK |  |  |  |  |  |  | SAI1_SD_A | I2S3_SD/SPI3_MOSI |  | QUADSPI_CLK
M06 | PF12 | I/O | FMC | ADDRESS | FMC_A06 | FMC_A06 |  |  |  |  |  |  |  |  |  |  |  |  | FMC_A6
M07 | PG01 | I/O | FMC | ADDRESS | FMC_A11 | FMC_A11 |  |  |  |  |  |  |  |  |  |  |  |  | FMC_A11
M08 | PF15 | I/O | FMC | ADDRESS | FMC_A09 | FMC_A09 |  |  |  |  | I2C4_SDA |  |  |  |  |  |  |  | FMC_A9
M09 | PJ04 | I/O | LTDC | RED | LTDC_R5 | LTDC_R5 |  |  |  |  |  |  |  |  |  |  |  |  |  |  | LTDC_R5
M10 | PD12 | I/O | FMC | ADDRESS | FMC_A17 | FMC_A17 |  |  | TIM4_CH1 | LPTIM1_IN1 | I2C4_SCL |  |  | USART3_DE/USART3_RTS |  | QUADSPI_BK1_IO1 | SAI2_FS_A |  | FMC_A17/FMC_ALE
M11 | PD13 | I/O | FMC | ADDRESS | FMC_A18 | FMC_A18 |  |  | TIM4_CH2 | LPTIM1_OUT | I2C4_SDA |  |  |  |  | QUADSPI_BK1_IO3 | SAI2_SCK_A |  | FMC_A18
M12 | PG03 | I/O | FMC | ADDRESS | FMC_A13 | FMC_A13 |  |  |  |  |  |  |  |  |  |  |  |  | FMC_A13
M13 | PG02 | I/O | FMC | ADDRESS | FMC_A12 | FMC_A12 |  |  |  |  |  |  |  |  |  |  |  |  | FMC_A12
M14 | PJ05 | I/O | LTDC | RED | LTDC_R6 | LTDC_R6 |  |  |  |  |  |  |  |  |  |  |  |  |  |  | LTDC_R6
M15 | PH12 | I/O | DCMI | DATA | DCMI_D3 | DCMI_D03 |  |  | TIM5_CH3 |  | I2C4_SDA |  |  |  |  |  |  |  | FMC_D20 | DCMI_D3 | LTDC_R6
N01 | VREF- | Power
B03 | PG13 | I/O | UART | CONTROL | USART6_CTS | GSM_CTS | SYS_TRACED0 |  |  | LPTIM1_OUT |  | SPI6_SCK |  |  | USART6_CTS |  |  | ETH_TXD0 | FMC_A24 |  | LTDC_R0
N03 | PA00 | I/O | GPIO | INPUT | SYS_WKUP1 | SYS_WAKUP |  | TIM2_CH1/TIM2_ETR | TIM5_CH1 | TIM8_ETR |  |  |  | USART2_CTS | UART4_TX |  | SAI2_SD_B | ETH_CRS
N04 | PA04 | I/O | DCMI | CONTROL | DCMI_HSYNC | DCMI_HSYNC |  |  |  |  |  | I2S1_WS/SPI1_NSS | I2S3_WS/SPI3_NSS | USART2_CK |  |  |  |  | USB_OTG_HS_SOF | DCMI_HSYNC | LTDC_VSYNC
A04 | PG14 | I/O | UART | DATA | USART6_TX | GSM_TX | SYS_TRACED1 |  |  | LPTIM1_ETR |  | SPI6_MOSI |  |  | USART6_TX | QUADSPI_BK2_IO3 |  | ETH_TXD1 | FMC_A25 |  | LTDC_B0
N06 | PF13 | I/O | FMC | ADDRESS | FMC_A07 | FMC_A07 |  |  |  |  | I2C4_SMBA |  |  |  |  |  |  |  | FMC_A7
N07 | PG00 | I/O | FMC | ADDRESS | FMC_A10 | FMC_A10 |  |  |  |  |  |  |  |  |  |  |  |  | FMC_A10
N08 | PJ03 | I/O | LTDC | RED | LTDC_R4 | LTDC_R4 |  |  |  |  |  |  |  |  |  |  |  |  |  |  | LTDC_R4
N09 | PE08 | I/O | FMC | DATA | FMC_D05 | FMC_D05 |  | TIM1_CH1N |  |  |  |  |  |  | UART7_TX |  | QUADSPI_BK2_IO1 |  | FMC_D5/FMC_DA5
N10 | PD11 | I/O | FMC | ADDRESS | FMC_A16 | FMC_A16 |  |  |  |  | I2C4_SMBA |  |  | USART3_CTS |  | QUADSPI_BK1_IO0 | SAI2_SD_A |  | FMC_A16/FMC_CLE
N11 | PG05 | I/O | FMC | ADDRESS | FMC_A15 | FMC_A15 |  |  |  |  |  |  |  |  |  |  |  |  | FMC_A15/FMC_BA1
N12 | PG04 | I/O | FMC | ADDRESS | FMC_A14 | FMC_A14 |  |  |  |  |  |  |  |  |  |  |  |  | FMC_A14/FMC_BA0
N13 | PH07 | I/O |  |  |  |  |  |  |  |  | I2C3_SCL | SPI5_MISO |  |  |  |  |  | ETH_RXD3 | FMC_SDCKE1 | DCMI_D9
N14 | PH09 | I/O | LTDC | RED | LTDC_R3 | LTDC_R3 |  |  |  |  | I2C3_SMBA |  |  |  |  | TIM12_CH2 |  |  | FMC_D17 | DCMI_D0 | LTDC_R3
P14 | PH08 | I/O | I2C | DATA | I2C3_SDA | EXP_SDA |  |  |  |  | I2C3_SDA |  |  |  |  |  |  |  | FMC_D16 | DCMI_HSYNC | LTDC_R2
P01 | VREF+ | Power
N15 | PH11 | Output | GPIO | OUTPUT | GPIO_Output | GSM_PWE |  |  | TIM5_CH2 |  | I2C4_SCL |  |  |  |  |  |  |  | FMC_D19 | DCMI_D2 | LTDC_R5
P03 | PA06 | I/O | DCMI | CONTROL | DCMI_PIXCLK | DCMI_PIXCLK |  | TIM1_BKIN | TIM3_CH1 | TIM8_BKIN |  | SPI1_MISO |  |  |  | TIM13_CH1 |  |  |  | DCMI_PIXCLK | LTDC_G2
P04 | PA05 | I/O | SPI | CLOCK | SPI1_SCK | DCMI_SCL |  | TIM2_CH1/TIM2_ETR |  | TIM8_CH1N |  | I2S1_CK/SPI1_SCK |  |  |  |  | USB_OTG_HS_ULPI_CK |  |  |  | LTDC_R4
C14 | PI02 | I/O | SPI | DATA | SPI2_MISO | WiFi_MISO |  |  |  | TIM8_CH4 |  | SPI2_MISO |  |  |  |  |  |  | FMC_D26 | DCMI_D9 | LTDC_G7
P06 | PF14 | I/O | FMC | ADDRESS | FMC_A08 | FMC_A08 |  |  |  |  | I2C4_SCL |  |  |  |  |  |  |  | FMC_A8
P07 | PJ02 | I/O |  |  | EXP_GPIO2 |  |  |  |  |  |  |  |  |  |  |  |  |  |  |  | LTDC_R3
P08 | PF11 | I/O | FMC | CONTROL | FMC_SDNRAS | FMC_SDNRAS |  |  |  |  |  | SPI5_MOSI |  |  |  |  | SAI2_SD_B |  | FMC_SDNRAS | DCMI_D12
P09 | PE09 | I/O | FMC | DATA | FMC_D06 | FMC_D06 |  | TIM1_CH1 |  |  |  |  |  |  | UART7_DE/UART7_RTS |  | QUADSPI_BK2_IO2 |  | FMC_D6/FMC_DA6
P10 | PE11 | I/O | FMC | DATA | FMC_D08 | FMC_D08 |  | TIM1_CH2 |  |  |  | SPI4_NSS |  |  |  |  | SAI2_SD_B |  | FMC_D8/FMC_DA8 |  | LTDC_G3
P11 | PE14 | I/O | FMC | DATA | FMC_D11 | FMC_D11 |  | TIM1_CH4 |  |  |  | SPI4_MOSI |  |  |  |  | SAI2_MCLK_B |  | FMC_D11/FMC_DA11 |  | LTDC_CLK
C13 | PI03 | I/O | SPI | DATA | SPI2_MOSI | WiFi_MOSI |  |  |  | TIM8_ETR |  | I2S2_SD/SPI2_MOSI |  |  |  |  |  |  | FMC_D27 | DCMI_D10
P13 | PH06 | I/O |  |  |  | EXP_GPIO4 |  |  |  |  | I2C2_SMBA | SPI5_SCK |  |  |  | TIM12_CH1 |  | ETH_RXD2 | FMC_SDNE1 | DCMI_D8
E04 | PI09 | I/O | CAN | DATA | CAN1_RX | CAN_RX |  |  |  |  |  |  |  |  |  | CAN1_RX |  |  | FMC_D30 |  | LTDC_VSYNC
P15 | PH10 | I/O | DCMI | DATA | DCMI_D1 | DCMI_D01 |  |  | TIM5_CH1 |  | I2C4_SMBA |  |  |  |  |  |  |  | FMC_D18 | DCMI_D1 | LTDC_R4
R01 | VDDA | Power
R02 | PA03 | I/O | ANALOG | INPUT | ADC1_IN3 | VBATT_SENSE |  | TIM2_CH4 | TIM5_CH4 | TIM9_CH2 |  |  |  | USART2_RX |  |  | USB_OTG_HS_ULPI_D0 | ETH_COL |  |  | LTDC_B5
K12 | PJ06 | Output | GPIO | OUTPUT | GPIO_Output | GSM_RST |  |  |  |  |  |  |  |  |  |  |  |  |  |  | LTDC_R7
J13 | PJ09 | Input | GPIO | INPUT | GPIO_Input | GSM_RI |  |  |  |  |  |  |  |  |  |  |  |  |  |  | LTDC_G2
R05 | PB00 | I/O | TIMER | PWM | TIM8_CH2N | DCMI_LIGHT |  | TIM1_CH2N | TIM3_CH3 | TIM8_CH2N |  |  |  |  | UART4_CTS | LTDC_R3 | USB_OTG_HS_ULPI_D1 | ETH_RXD2
R06 | PJ00 | I/O | LTDC | RED | LTDC_R1 | LTDC_R1 |  |  |  |  |  |  |  |  |  |  |  |  |  |  | LTDC_R1
R07 | PJ01 | I/O | LTDC | RED | LTDC_R2 | LTDC_R2 |  |  |  |  |  |  |  |  |  |  |  |  |  |  | LTDC_R2
R08 | PE07 | I/O | FMC | DATA | FMC_D04 | FMC_D04 |  | TIM1_ETR |  |  |  |  |  |  | UART7_RX |  | QUADSPI_BK2_IO0 |  | FMC_D4/FMC_DA4
R09 | PE10 | I/O | FMC | DATA | FMC_D07 | FMC_D07 |  | TIM1_CH2N |  |  |  |  |  |  | UART7_CTS |  | QUADSPI_BK2_IO3 |  | FMC_D7/FMC_DA7
R10 | PE12 | I/O | FMC | DATA | FMC_D09 | FMC_D09 |  | TIM1_CH3N |  |  |  | SPI4_SCK |  |  |  |  | SAI2_SCK_B |  | FMC_D9/FMC_DA9 |  | LTDC_B4
R11 | PE15 | I/O | FMC | DATA | FMC_D12 | FMC_D12 |  | TIM1_BKIN |  |  |  |  |  |  |  |  |  |  | FMC_D12/FMC_DA12 |  | LTDC_R7
R12 | PE13 | I/O | FMC | DATA | FMC_D10 | FMC_D10 |  | TIM1_CH3 |  |  |  | SPI4_MISO |  |  |  |  | SAI2_FS_B |  | FMC_D10/FMC_DA10 |  | LTDC_DE
G13 | PK00 | Output | GPIO | OUTPUT | GPIO_Output | GSM_DTR |  |  |  |  |  |  |  |  |  |  |  |  |  |  | LTDC_G5
R14 | PB14 | I/O | USB | DATA | USB_OTG_HS_DM | USB_DM |  | TIM1_CH2N |  | TIM8_CH2N |  | SPI2_MISO |  | USART3_DE/USART3_RTS |  | TIM12_CH1 |  |  | USB_OTG_HS_DM
R15 | PB15 | I/O | USB | DATA | USB_OTG_HS_DP | USB_DP | RTC_REFIN | TIM1_CH3N |  | TIM8_CH3N |  | I2S2_SD/SPI2_MOSI |  |  |  | TIM12_CH2 |  |  | USB_OTG_HS_DP

Sheet: Stack Up
Name | Type
L1 (Top Layer) | Low speed signals
L2 | 3v3 power layer
L3 | High speed signals
L4 | High speed signals
L5 | GND power layer
L6 (Bottom Layer) | Low speed signals

Sheet: Signal Groups
Signal | Speed | Type | Layer
USB | High speed | Differential Pair | L3
CAN | Low speed | Differential Pair | L6
DCMI | High speed | Single ended | L4
ETHERNET | High speed | Single ended | L6
FMC | High speed | Single ended | L4
LTDC | High speed | Single ended | L4
OSC | High speed | Single ended | L3
QSPI | High speed | Single ended | L3
SDCARD | High speed | Single ended | L3
ANALOG | Low speed | Single ended | L1
GPIO | Low speed | Single ended | L1
I2C | Low speed | Single ended | L1
JTAG | Low speed | Single ended | L1
SPI | Low speed | Single ended | L1
UART | Low speed | Single ended | L1
