yldzmuhammed/STF7-SoM/doc/en.stm32f7x9i-eval_sch/MB1166A_Altium_Schematic-Allegro_Layout/MB1166.pdf

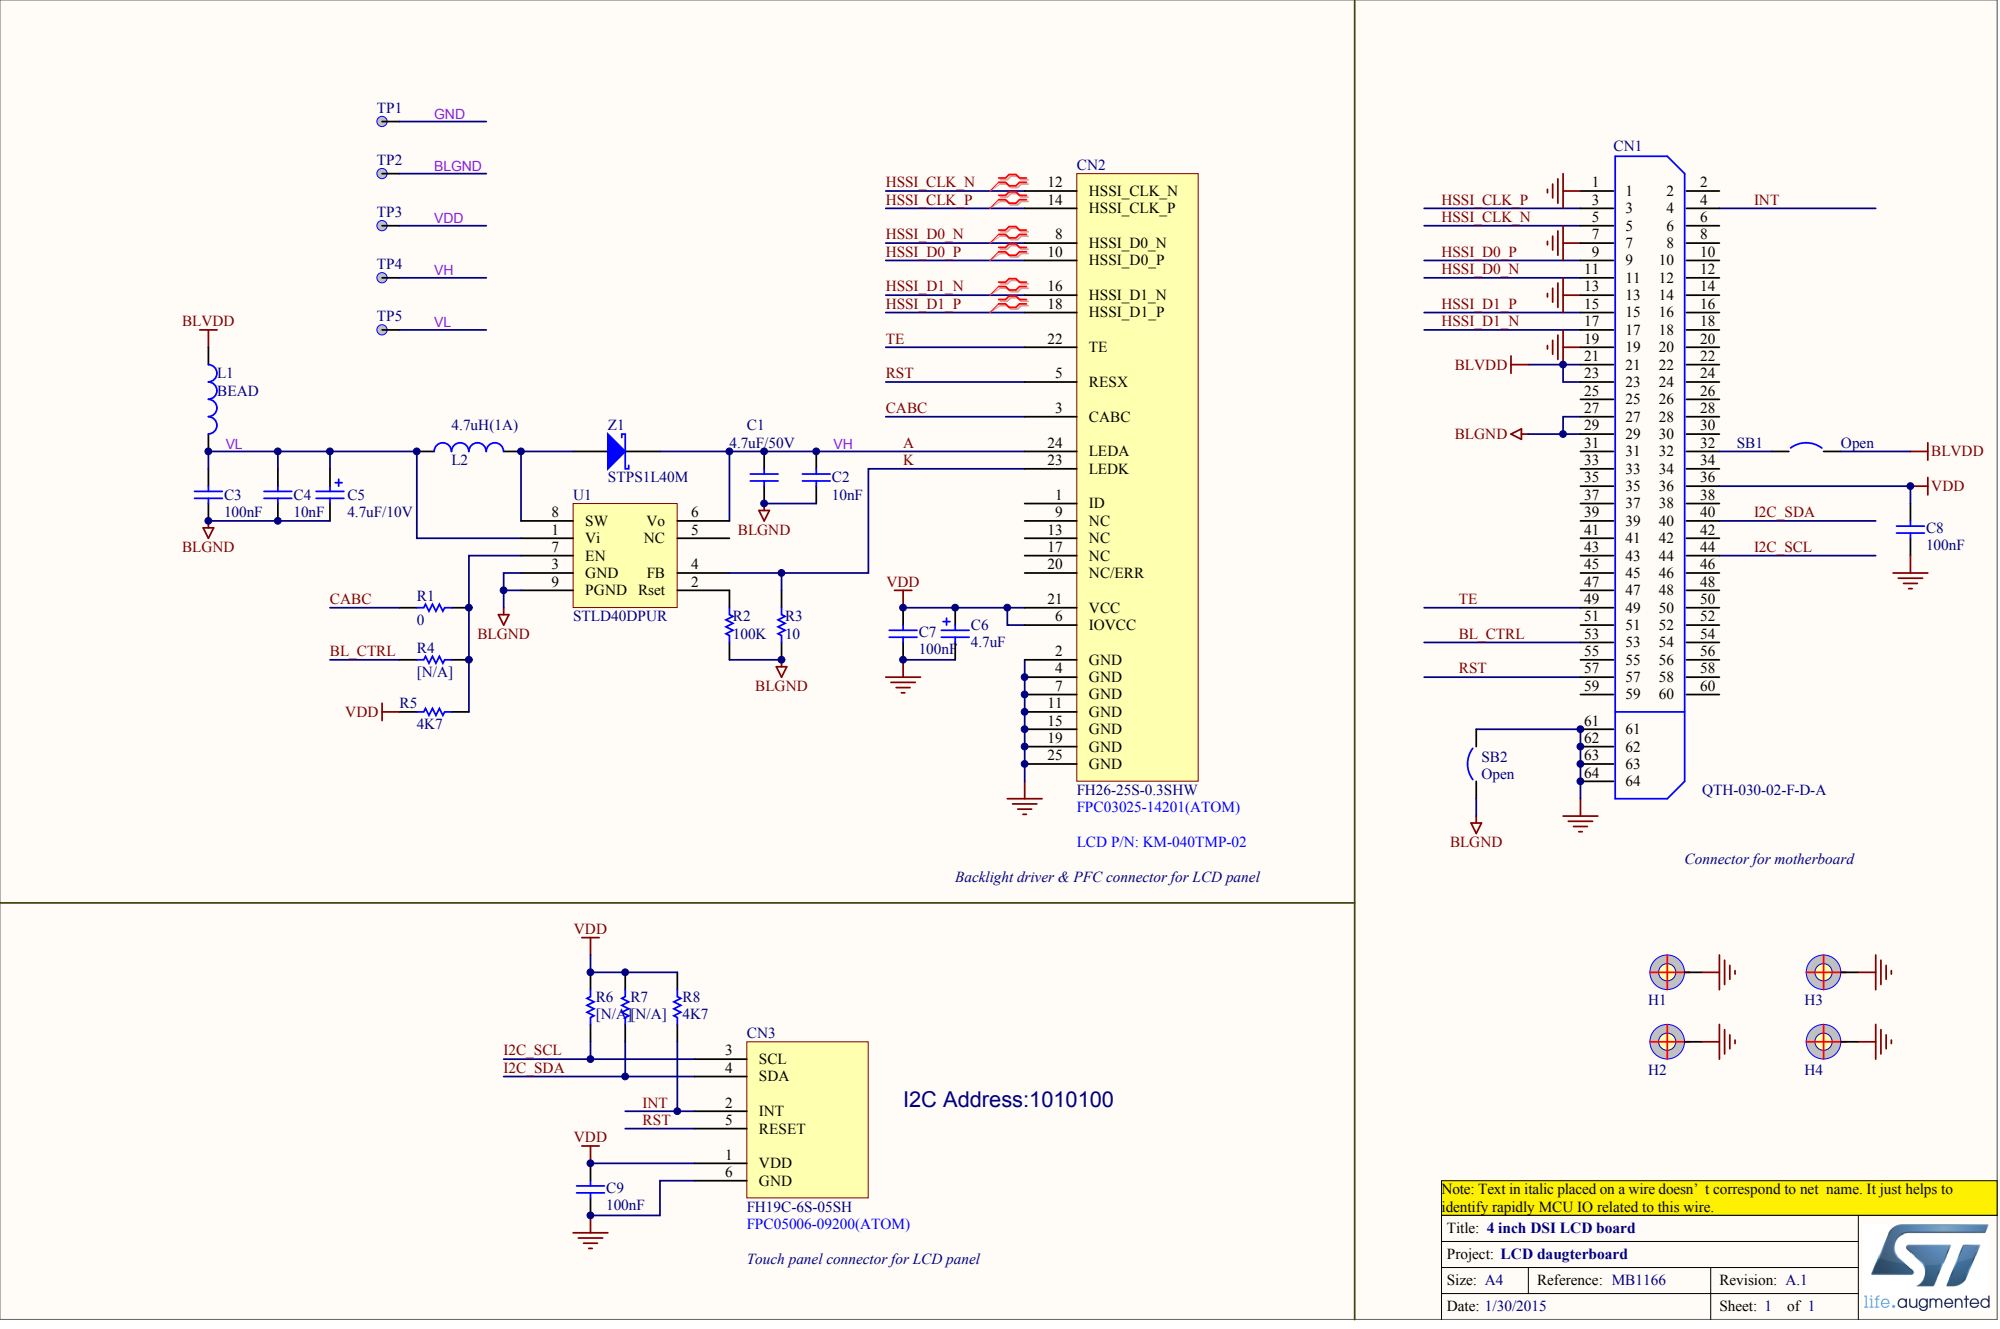
[picture p10: page 1]

Backlight driver & PFC connector for LCD panel

Note: Text in italic placed on a wire doesn’t correspond to net name. It just helps to
identify rapidly MCU IO related to this wire.
Title:
4 inch DSI LCD board

Project: LCD daugterboard Touch panel connector for LCD panel
