yldzmuhammed/STF7-SoM/doc/STF7SoM Assembly Drawing.PDF

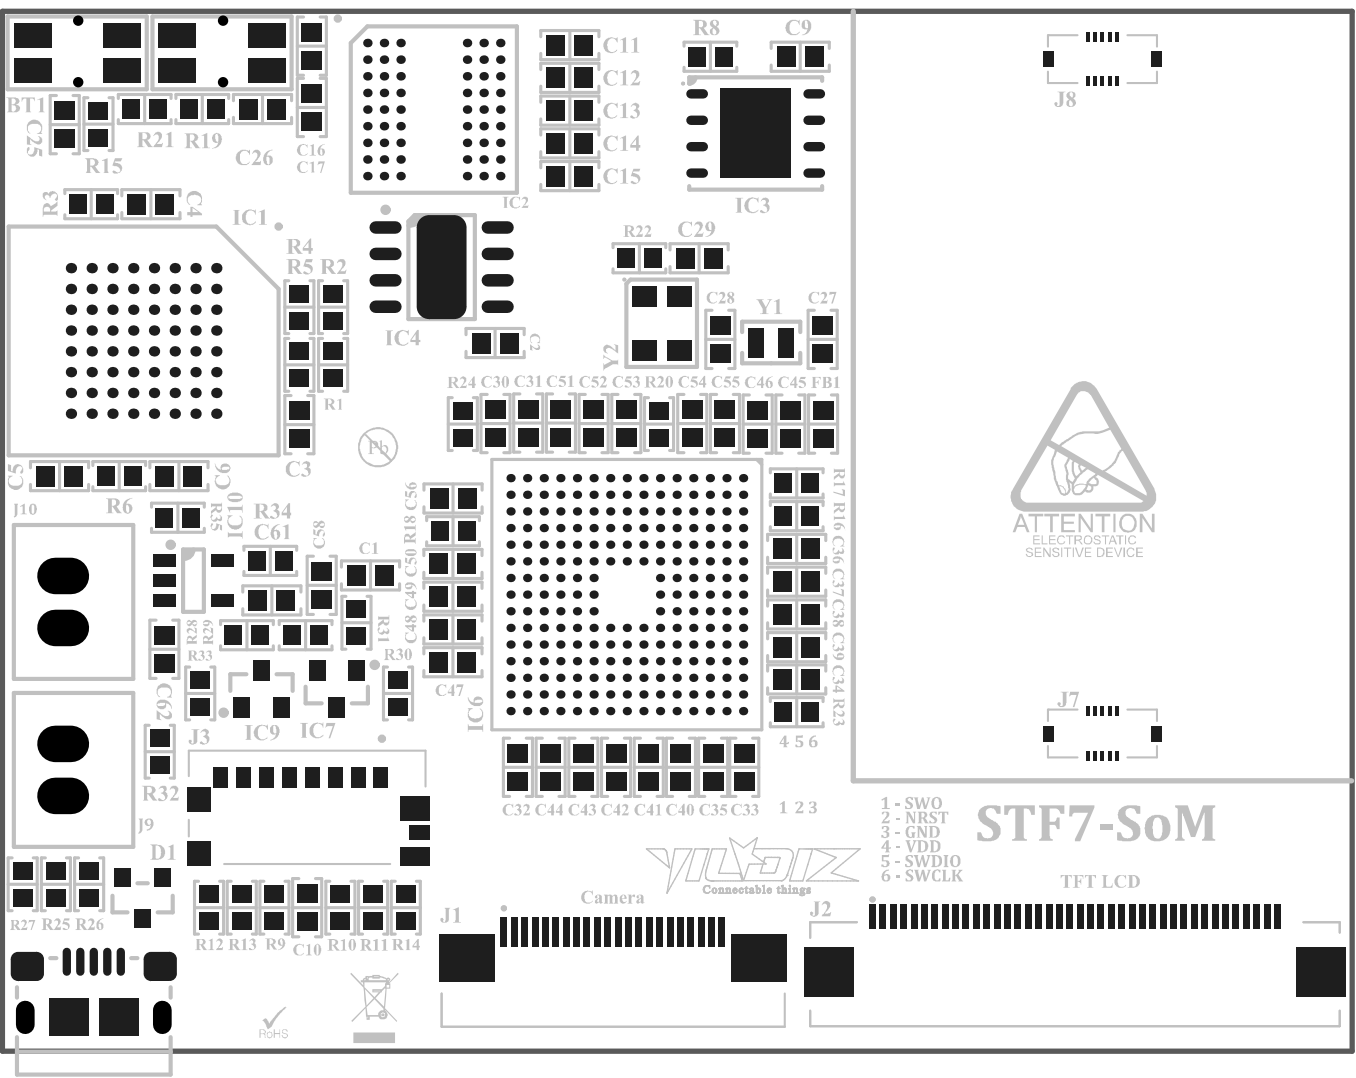
[picture p11: page 1]

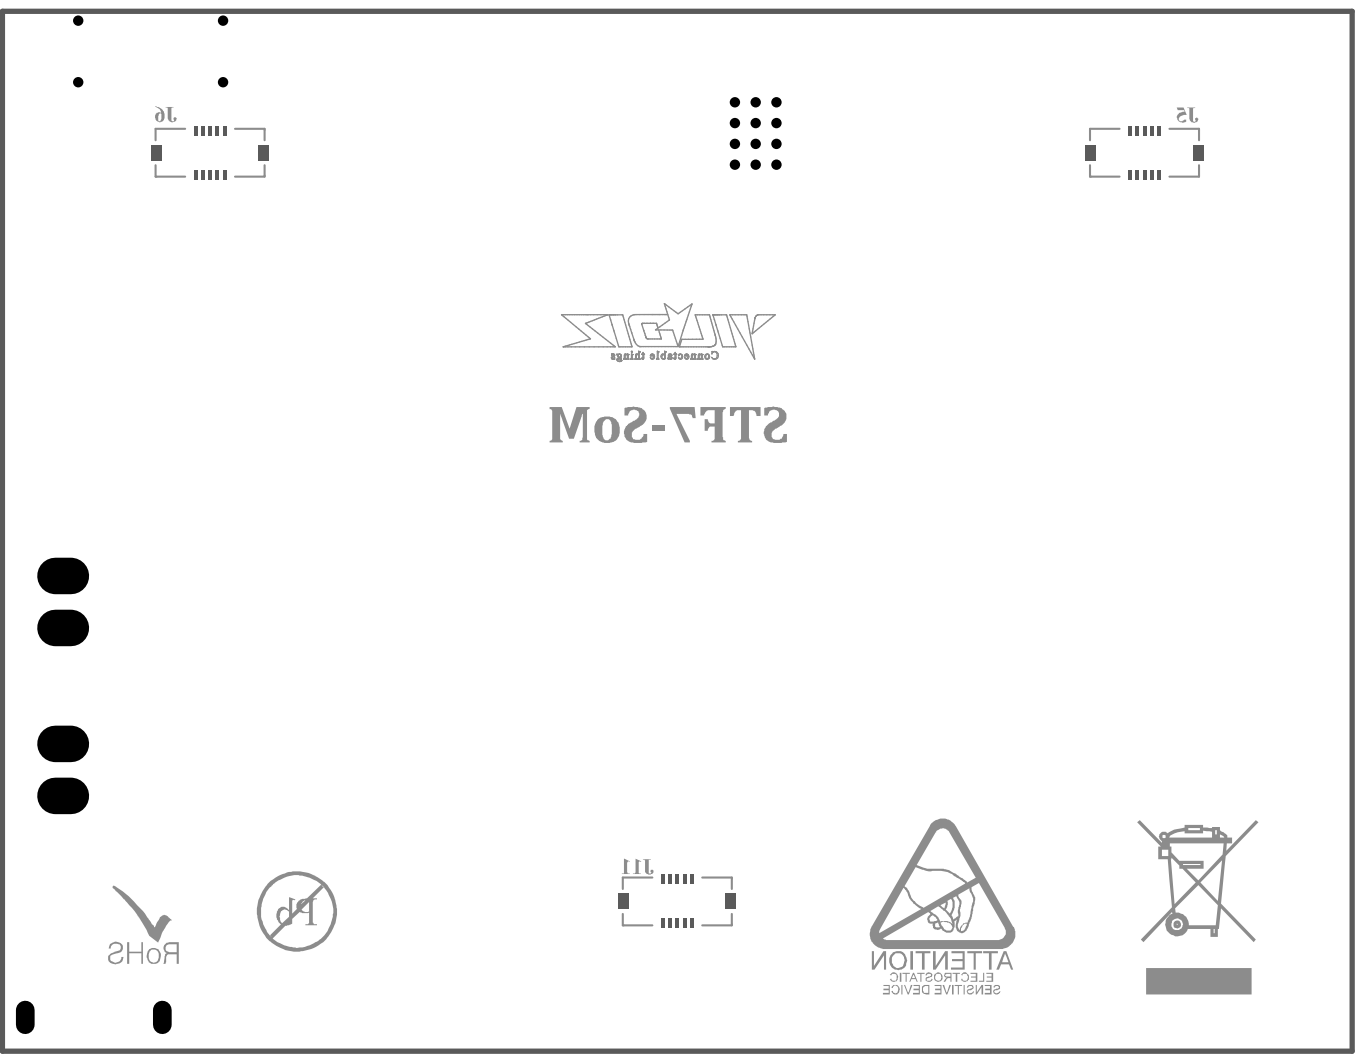
[picture p12: page 2]
