yldzmuhammed/STF7-SoM/(list of files, drawings)

Other design files:
baseboard/Camera.SchDoc
baseboard/Connections.SchDoc
baseboard/LCD.SchDoc
baseboard/Paralel NOR FLASH.SchDoc
baseboard/Power.SchDoc
baseboard/PSRAM.SchDoc
baseboard/QSPI FLASH.SchDoc
baseboard/SD Card.SchDoc
baseboard/SDRAM 1.SchDoc
baseboard/SDRAM 2.SchDoc
baseboard/STM32F7.SchDoc
baseboard/STM32F7_BaseBoard.PrjPcb
baseboard/STM32F7_BaseBoard.SchDoc
baseboard/USB Device.SchDoc
baseboard/USB Host.SchDoc
baseboard/USB.SchDoc
doc/en.stm32f7x9i-eval_sch/MB1166A_Altium_Schematic-Allegro_Layout/MB1166.PrjPCB
doc/en.stm32f7x9i-eval_sch/MB1166A_Altium_Schematic-Allegro_Layout/MB1166.SchDoc
doc/en.stm32f7x9i-eval_sch/MB1183C_Altium_Schematic_Layout/MB1183.PcbDoc
doc/en.stm32f7x9i-eval_sch/MB1183C_Altium_Schematic_Layout/MB1183.PrjPCB
doc/en.stm32f7x9i-eval_sch/MB1183C_Altium_Schematic_Layout/MB1183.SchDoc
doc/en.stm32f7x9i-eval_sch/MB1219B_Altium_Schematic-Allegro_Layout/Audio.SchDoc
doc/en.stm32f7x9i-eval_sch/MB1219B_Altium_Schematic-Allegro_Layout/CAN&QSPI.SchDoc
doc/en.stm32f7x9i-eval_sch/MB1219B_Altium_Schematic-Allegro_Layout/Ethernet.SchDoc
doc/en.stm32f7x9i-eval_sch/MB1219B_Altium_Schematic-Allegro_Layout/ExtensionConnector.SchDoc
doc/en.stm32f7x9i-eval_sch/MB1219B_Altium_Schematic-Allegro_Layout/JTAG&Trace.SchDoc
doc/en.stm32f7x9i-eval_sch/MB1219B_Altium_Schematic-Allegro_Layout/LCD&Camera&Connectors.SchDoc
doc/en.stm32f7x9i-eval_sch/MB1219B_Altium_Schematic-Allegro_Layout/MB1219.PrjPCB
doc/en.stm32f7x9i-eval_sch/MB1219B_Altium_Schematic-Allegro_Layout/MB1219.SchDoc
doc/en.stm32f7x9i-eval_sch/MB1219B_Altium_Schematic-Allegro_Layout/MCU.SchDoc
doc/en.stm32f7x9i-eval_sch/MB1219B_Altium_Schematic-Allegro_Layout/Memory.SchDoc
doc/en.stm32f7x9i-eval_sch/MB1219B_Altium_Schematic-Allegro_Layout/MFX & LEDs.SchDoc
doc/en.stm32f7x9i-eval_sch/MB1219B_Altium_Schematic-Allegro_Layout/MotorControl.SchDoc
doc/en.stm32f7x9i-eval_sch/MB1219B_Altium_Schematic-Allegro_Layout/Peripherals.SchDoc
doc/en.stm32f7x9i-eval_sch/MB1219B_Altium_Schematic-Allegro_Layout/Power.SchDoc
doc/en.stm32f7x9i-eval_sch/MB1219B_Altium_Schematic-Allegro_Layout/RS232.SchDoc
doc/en.stm32f7x9i-eval_sch/MB1219B_Altium_Schematic-Allegro_Layout/ST_LINK_V2-1.SCHDOC
doc/en.stm32f7x9i-eval_sch/MB1219B_Altium_Schematic-Allegro_Layout/USB_OTG.SchDoc
doc/en.stm32f7x9i-eval_sch/MB1219B_Altium_Schematic-Allegro_Layout/USB_OTG_FS.SchDoc
doc/en.stm327x6g-eval_sch/MB1063B_ALTIUM-Schematics_ALLEGRO-Layout/MB1063.PrjPCB
doc/en.stm327x6g-eval_sch/MB1063B_ALTIUM-Schematics_ALLEGRO-Layout/MB1063.SchDoc
doc/en.stm327x6g-eval_sch/MB1063B_ALTIUM-Schematics_ALLEGRO-Layout/MB1063.SCHLIB
doc/en.stm327x6g-eval_sch/MB1167B_ALTIUM-Schematics_ALLEGRO-Layout/Audio.SchDoc
doc/en.stm327x6g-eval_sch/MB1167B_ALTIUM-Schematics_ALLEGRO-Layout/CAN&QSPI.SchDoc
doc/en.stm327x6g-eval_sch/MB1167B_ALTIUM-Schematics_ALLEGRO-Layout/Ethernet.SchDoc
doc/en.stm327x6g-eval_sch/MB1167B_ALTIUM-Schematics_ALLEGRO-Layout/ExtensionConnector.SchDoc
doc/en.stm327x6g-eval_sch/MB1167B_ALTIUM-Schematics_ALLEGRO-Layout/JTAG&Trace.SchDoc
doc/en.stm327x6g-eval_sch/MB1167B_ALTIUM-Schematics_ALLEGRO-Layout/LCD&Camera&Connectors.SchDoc
doc/en.stm327x6g-eval_sch/MB1167B_ALTIUM-Schematics_ALLEGRO-Layout/MB1167.PrjPCB
doc/en.stm327x6g-eval_sch/MB1167B_ALTIUM-Schematics_ALLEGRO-Layout/MB1167.SchDoc
doc/en.stm327x6g-eval_sch/MB1167B_ALTIUM-Schematics_ALLEGRO-Layout/MB1167.SCHLIB
doc/en.stm327x6g-eval_sch/MB1167B_ALTIUM-Schematics_ALLEGRO-Layout/MCU.SchDoc
doc/en.stm327x6g-eval_sch/MB1167B_ALTIUM-Schematics_ALLEGRO-Layout/Memory.SchDoc
doc/en.stm327x6g-eval_sch/MB1167B_ALTIUM-Schematics_ALLEGRO-Layout/MFX.SchDoc
doc/en.stm327x6g-eval_sch/MB1167B_ALTIUM-Schematics_ALLEGRO-Layout/MotorControl.SchDoc
doc/en.stm327x6g-eval_sch/MB1167B_ALTIUM-Schematics_ALLEGRO-Layout/Peripherals.SchDoc
doc/en.stm327x6g-eval_sch/MB1167B_ALTIUM-Schematics_ALLEGRO-Layout/Power.SchDoc
doc/en.stm327x6g-eval_sch/MB1167B_ALTIUM-Schematics_ALLEGRO-Layout/RS232&IrDA.SchDoc
doc/en.stm327x6g-eval_sch/MB1167B_ALTIUM-Schematics_ALLEGRO-Layout/ST_LINK_V2-1.SCHDOC
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
