yldzmuhammed/STF7-SoM/software/STF7-SoM.ioc

Mcu.UserName=STM32F750N8Hx
PA0/WKUP.GPIO_Label=SYS_WAKUP
PA0/WKUP.Signal=SYS_WKUP1
PA1.GPIO_Label=ETH_REF_CLK
PA1.Signal=ETH_REF_CLK
PA10.GPIO_Label=WiFi_RX
PA10.Signal=USART1_RX
PA11.GPIO_Label=WiFi_CTS
PA11.Signal=USART1_CTS
PA12.GPIO_Label=WiFi_RTS
PA12.Signal=USART1_RTS
PA13.GPIO_Label=SWDIO
PA13.Signal=SYS_JTMS-SWDIO
PA14.GPIO_Label=SWCLK
PA14.Signal=SYS_JTCK-SWCLK
PA15.GPIO_Label=WiFi_PWE
PA15.Signal=GPIO_Output
PA2.GPIO_Label=ETH_MDIO
PA2.Signal=ETH_MDIO
PA3.GPIO_Label=VBATT_SENSE
PA3.Signal=ADCx_IN3
PA4.GPIO_Label=DCMI_HSYNC
PA4.Signal=DCMI_HSYNC
PA5.GPIO_Label=DCMI_SCL
PA5.Signal=SPI1_SCK
PA6.GPIO_Label=DCMI_PIXCLK
PA6.Signal=DCMI_PIXCLK
PA7.GPIO_Label=ETH_CRS_DV
PA7.Signal=ETH_CRS_DV
PA8.GPIO_Label=EXP_SCL
PA8.Signal=I2C3_SCL
PA9.GPIO_Label=WiFi_TX
PA9.Signal=USART1_TX
PB0.GPIO_Label=DCMI_LIGHT
PB0.Signal=TIM8_CH2N
PB1.GPIO_Label=RS485_DE
PB1.Signal=GPIO_Output
PB10.GPIO_Label=RS485_TX
PB10.Signal=USART3_TX
PB11.GPIO_Label=RS485_RX
PB11.Signal=USART3_RX
PB12.GPIO_Label=ETH_TXD0
PB12.Signal=ETH_TXD0
PB13.GPIO_Label=ETH_TXD1
PB13.Signal=ETH_TXD1
PB14.GPIO_Label=USB_DM
PB14.Signal=USB_OTG_HS_DM
PB15.GPIO_Label=USB_DP
PB15.Signal=USB_OTG_HS_DP
PB2.GPIO_Label=QSP_CLK
PB2.Signal=QUADSPI_CLK
PB3.GPIO_Label=SWO
PB3.Signal=SYS_JTDO-SWO
PB4.GPIO_Label=DCMI_MISO
PB4.Signal=SPI1_MISO
PB5.GPIO_Label=DCMI_MOSI
PB5.Signal=SPI1_MOSI
PB6.GPIO_Label=QSP_NCS
PB6.Signal=QUADSPI_BK1_NCS
PB7.GPIO_Label=DCMI_SDA
PB7.Signal=I2C1_SDA
PB8.GPIO_Label=DCMI_SCL
PB8.Signal=I2C1_SCL
PB9.GPIO_Label=CAN_TX
PB9.Signal=CAN1_TX
PC0.GPIO_Label=FMC_SDNWE
PC0.Signal=FMC_SDNWE
PC1.GPIO_Label=ETH_MDC
PC1.Signal=ETH_MDC
PC10.GPIO_Label=SD_D2
PC10.Signal=SDMMC1_D2
PC11.GPIO_Label=SD_D3
PC11.Signal=SDMMC1_D3
PC12.GPIO_Label=SD_CK
PC12.Signal=SDMMC1_CK
PC13.GPIO_Label=EXP_GPIO3
PC13.Signal=GPIO_Output
PC14/OSC32_IN.GPIO_Label=LS_OSC1
PC14/OSC32_IN.Signal=RCC_OSC32_IN
PC15/OSC32_OUT.GPIO_Label=LS_OSC2
PC15/OSC32_OUT.Signal=RCC_OSC32_OUT
PC2.GPIO_Label=RMII_RXER
PC2.Signal=GPIO_Input
PC3.GPIO_Label=EXP_GPIO1
PC3.Signal=GPIO_Output
PC4.GPIO_Label=ETH_RXD0
PC4.Signal=ETH_RXD0
PC5.GPIO_Label=ETH_RXD1
PC5.Signal=ETH_RXD1
PC6.GPIO_Label=DCMI_D0
PC6.Signal=DCMI_D0
PC7.GPIO_Label=GSM_RX
PC7.Signal=USART6_RX
PC8.GPIO_Label=SD_D0
PC8.Signal=SDMMC1_D0
PC9.GPIO_Label=SD_D1
PC9.Signal=SDMMC1_D1
PD0.GPIO_Label=FMC_D2
PD0.Signal=FMC_D2_DA2
PD1.GPIO_Label=FMC_D3
PD1.Signal=FMC_D3_DA3
PD10.GPIO_Label=FMC_D15
PD10.Signal=FMC_D15_DA15
PD11.GPIO_Label=FMC_A16
PD11.Signal=FMC_A16_CLE
PD12.GPIO_Label=FMC_A17
PD12.Signal=FMC_A17_ALE
PD13.GPIO_Label=FMC_A18
PD13.Signal=FMC_A18
PD14.GPIO_Label=FMC_D0
PD14.Signal=FMC_D0_DA0
PD15.GPIO_Label=FMC_D1
PD15.Signal=FMC_D1_DA1
PD2.GPIO_Label=SD_CMD
PD2.Signal=SDMMC1_CMD
PD3.GPIO_Label=WiFi_SCK
PD3.Signal=SPI2_SCK
PD4.GPIO_Label=FMC_NOE
PD4.Signal=FMC_NOE
PD5.GPIO_Label=FMC_NWE
PD5.Signal=FMC_NWE
PD6.GPIO_Label=FMC_NWAIT
PD6.Signal=FMC_NWAIT
PD7.GPIO_Label=FMC_NE
PD7.Signal=FMC_NE1
PD8.GPIO_Label=FMC_D13
PD8.Signal=FMC_D13_DA13
PD9.GPIO_Label=FMC_D14
PD9.Signal=FMC_D14_DA14
PE0.GPIO_Label=FMC_NBL0
PE0.Signal=FMC_NBL0
PE1.GPIO_Label=FMC_NBL1
PE1.Signal=FMC_NBL1
PE10.GPIO_Label=FMC_D7
PE10.Signal=FMC_D7_DA7
PE11.GPIO_Label=FMC_D8
PE11.Signal=FMC_D8_DA8
PE12.GPIO_Label=FMC_D9
PE12.Signal=FMC_D9_DA9
PE13.GPIO_Label=FMC_D10
PE13.Signal=FMC_D10_DA10
PE14.GPIO_Label=FMC_D11
PE14.Signal=FMC_D11_DA11
PE15.GPIO_Label=FMC_D12
PE15.Signal=FMC_D12_DA12
PE2.GPIO_Label=QSP_IO2
PE2.Signal=QUADSPI_BK1_IO2
PE3.GPIO_Label=FMC_A19
PE3.Signal=FMC_A19
PE4.GPIO_Label=FMC_A20
PE4.Signal=FMC_A20
PE5.GPIO_Label=FMC_A21
PE5.Signal=FMC_A21
PE6.GPIO_Label=DCMI_D7
PE6.Signal=DCMI_D7
PE7.GPIO_Label=FMC_D4
PE7.Signal=FMC_D4_DA4
PE8.GPIO_Label=FMC_D5
PE8.Signal=FMC_D5_DA5
PE9.GPIO_Label=FMC_D6
PE9.Signal=FMC_D6_DA6
PF0.GPIO_Label=FMC_A0
PF0.Signal=FMC_A0
PF1.GPIO_Label=FMC_A1
PF1.Signal=FMC_A1
PF10.GPIO_Label=EXP_GPIO0
PF10.Signal=GPIO_Output
PF11.GPIO_Label=FMC_SDNRAS
PF11.Signal=FMC_SDNRAS
PF12.GPIO_Label=FMC_A6
PF12.Signal=FMC_A6
PF13.GPIO_Label=FMC_A7
PF13.Signal=FMC_A7
PF14.GPIO_Label=FMC_A8
PF14.Signal=FMC_A8
PF15.GPIO_Label=FMC_A9
PF15.Signal=FMC_A9
PF2.GPIO_Label=FMC_A2
PF2.Signal=FMC_A2
PF3.GPIO_Label=FMC_A3
PF3.Signal=FMC_A3
PF4.GPIO_Label=FMC_A4
PF4.Signal=FMC_A4
PF5.GPIO_Label=FMC_A5
PF5.Signal=FMC_A5
PF6.GPIO_Label=QSP_IO3
PF6.Signal=QUADSPI_BK1_IO3
PF7.GPIO_Label=LTDC_BL
PF7.Signal=S_TIM11_CH1
PF8.GPIO_Label=QSP_IO0
PF8.Signal=QUADSPI_BK1_IO0
PF9.GPIO_Label=QSP_IO1
PF9.Signal=QUADSPI_BK1_IO1
PG0.GPIO_Label=FMC_A10
PG0.Signal=FMC_A10
PG1.GPIO_Label=FMC_A11
PG1.Signal=FMC_A11
PG10.GPIO_Label=DCMI_D2
PG10.Signal=DCMI_D2
PG11.GPIO_Label=ETH_TX_EN
PG11.Signal=ETH_TX_EN
PG12.GPIO_Label=GSM_RTS
PG12.Signal=USART6_RTS
PG13.GPIO_Label=GSM_CTS
PG13.Signal=USART6_CTS
PG14.GPIO_Label=GSM_TX
PG14.Signal=USART6_TX
PG15.GPIO_Label=FMC_SDNCAS
PG15.Signal=FMC_SDNCAS
PG2.GPIO_Label=FMC_A12
PG2.Signal=FMC_A12
PG3.GPIO_Label=FMC_A13
PG3.Signal=FMC_A13
PG4.GPIO_Label=FMC_A14
PG4.Signal=FMC_A14_BA0
PG5.GPIO_Label=FMC_A15
PG5.Signal=FMC_A15_BA1
PG6.GPIO_Label=LTDC_R7
PG6.Signal=LTDC_R7
PG7.GPIO_Label=GSM_DCD
PG7.Signal=GPIO_Output
PG8.GPIO_Label=FMC_SDCLK
PG8.Signal=FMC_SDCLK
PG9.GPIO_Label=WiFi_IRQ
PG9.Signal=GPXTI9
PH0/OSC_IN.GPIO_Label=HS_OSC1
PH0/OSC_IN.Signal=RCC_OSC_IN
PH1/OSC_OUT.GPIO_Label=HS_OSC2
PH1/OSC_OUT.Signal=RCC_OSC_OUT
PH10.GPIO_Label=DCMI_D1
PH10.Signal=DCMI_D1
PH11.GPIO_Label=GSM_PWE
PH11.Signal=GPIO_Output
PH12.GPIO_Label=DCMI_D3
PH12.Signal=DCMI_D3
PH13.GPIO_Label=LTDC_G2
PH13.Signal=LTDC_G2
PH14.GPIO_Label=DCMI_D4
PH14.Signal=DCMI_D4
PH15.GPIO_Label=LTDC_G4
PH15.Signal=LTDC_G4
PH2.GPIO_Label=FMC_SDCKE0
PH2.Signal=FMC_SDCKE0
PH3.GPIO_Label=FMC_SDNE0
PH3.Signal=FMC_SDNE0
PH4.GPIO_Label=LTDC_SCL
PH4.Signal=I2C2_SCL
PH5.GPIO_Label=LTDC_SDA
PH5.Signal=I2C2_SDA
PH6.GPIO_Label=EXP_GPIO4
PH6.Signal=GPIO_Output
PH7.GPIO_Label=SD_DETECT
PH7.Signal=GPIO_Input
PH8.GPIO_Label=EXP_SDA
PH8.Signal=I2C3_SDA
PH9.GPIO_Label=LTDC_R3
PH9.Signal=LTDC_R3
PI0.GPIO_Label=LTDC_G5
PI0.Signal=LTDC_G5
PI1.GPIO_Label=LTDC_G6
PI1.Signal=LTDC_G6
PI10.GPIO_Label=LTDC_HSYNC
PI10.Signal=LTDC_HSYNC
PI11.GPIO_Label=VBATT_CHSTAT
PI11.Signal=GPIO_Input
PI12.GPIO_Label=DCMI_RST
PI12.Signal=GPIO_Output
PI13.GPIO_Label=LTDC_VSYNC
PI13.Signal=LTDC_VSYNC
PI14.GPIO_Label=LTDC_CLK
PI14.Signal=LTDC_CLK
PI15.GPIO_Label=LTDC_R0
PI15.Signal=LTDC_R0
PI2.GPIO_Label=WiFi_MISO
PI2.Signal=SPI2_MISO
PI3.GPIO_Label=WiFi_MOSI
PI3.Signal=SPI2_MOSI
PI4.GPIO_Label=DCMI_D5
PI4.Signal=DCMI_D5
PI5.GPIO_Label=DCMI_VSYNC
PI5.Signal=DCMI_VSYNC
PI6.GPIO_Label=DCMI_D6
PI6.Signal=DCMI_D6
PI7.GPIO_Label=DCMI_PWRE
PI7.Signal=GPIO_Output
PI8.GPIO_Label=LTDC_DISP
PI8.Signal=GPIO_Output
PI9.GPIO_Label=CAN_RX
PI9.Signal=CAN1_RX
PJ0.GPIO_Label=LTDC_R1
PJ0.Signal=LTDC_R1
PJ1.GPIO_Label=LTDC_R2
PJ1.Signal=LTDC_R2
PJ10.GPIO_Label=LTDC_G3
PJ10.Signal=LTDC_G3
PJ11.GPIO_Label=LTDC_TPIRQ
PJ11.Signal=GPIO_Input
PJ12.GPIO_Label=LTDC_B0
PJ12.Signal=LTDC_B0
PJ13.GPIO_Label=LTDC_B1
PJ13.Signal=LTDC_B1
PJ14.GPIO_Label=LTDC_B2
PJ14.Signal=LTDC_B2
PJ15.GPIO_Label=LTDC_B3
PJ15.Signal=LTDC_B3
PJ2.GPIO_Label=EXP_GPIO2
PJ2.Signal=GPIO_Output
PJ3.GPIO_Label=LTDC_R4
PJ3.Signal=LTDC_R4
PJ4.GPIO_Label=LTDC_R5
PJ4.Signal=LTDC_R5
PJ5.GPIO_Label=LTDC_R6
PJ5.Signal=LTDC_R6
PJ6.GPIO_Label=GSM_RST
PJ6.Signal=GPIO_Output
PJ7.GPIO_Label=LTDC_G0
PJ7.Signal=LTDC_G0
PJ8.GPIO_Label=LTDC_G1
PJ8.Signal=LTDC_G1
PJ9.GPIO_Label=GSM_RI
PJ9.Signal=GPIO_Input
PK0.GPIO_Label=GSM_DTR
PK0.Signal=GPIO_Output
PK1.GPIO_Label=LTDC_TPRST
PK1.Signal=GPIO_Output
PK2.GPIO_Label=LTDC_G7
PK2.Signal=LTDC_G7
PK3.GPIO_Label=LTDC_B4
PK3.Signal=LTDC_B4
PK4.GPIO_Label=LTDC_B5
PK4.Signal=LTDC_B5
PK5.GPIO_Label=LTDC_B6
PK5.Signal=LTDC_B6
PK6.GPIO_Label=LTDC_B7
PK6.Signal=LTDC_B7
PK7.GPIO_Label=LTDC_DE
PK7.Signal=LTDC_DE
