yldzmuhammed/STF7-SoM/(commit log)

2023-11-29 project moved from gitlab
    [Audio.SchDoc, Base Board BOM-STM32F7_BaseBoard.xls, CAN&QSPI.SchDoc, Camera BOM-Camera.xls, Camera.SchDoc, Connection BOM-Connections.xls, Connections.SchDoc, Ethernet.SchDoc]
2023-11-29 projects moved from gitlab
    [Base Board BOM-STM32F7_BaseBoard.xls, CAN BOM-CAN.xls, CAN.SchDoc, Camera BOM-Camera.xls, Camera.SchDoc, Connection BOM-Connections.xls, Connections.SchDoc, Ethernet BOM-Ethernet.xls]
2023-11-29 lcd module added
    [5 Inch Module.PrjPcb, 5 Inch Module.SchDoc, 7 Inch Module.PrjPcb, 7 Inch Module.SchDoc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]
